dragondgold/DigitalPowerSupply/UI_Firmware/U8g2_Arduino-master/README.md

# U8g2_Arduino: Arduino Monochrome Graphics Library

https://raw.githubusercontent.com/wiki/olikraus/u8g2/img/uc1701_dogs102_uno_board_320.jpg 

U8glib V2 library for Arduino

Description: https://github.com/olikraus/u8g2/wiki

Issue Tracker: https://github.com/olikraus/u8g2/issues

Download: https://github.com/olikraus/U8g2_Arduino/archive/master.zip
