dragondgold/DigitalPowerSupply/Documentacion/Informe.pdf

# Diseño y construcción de fuente conmutada tipo Buck de 75W

### Análisis en detalle del diseño y desarrollo de una fuente conmutada para presentarse como trabajo final en la Universidad Tecnológica Nacional de la ciudad de San Francisco, Córdoba

### Torti Andrés - Anchino Leonardo

### 24 de Agosto de 2017

´

# Indice general

1. Introducción | 4
2. Convertidores Buck | 6
3. Controlador PID | 12
4. Circuito de control | 26
5. Software | 34
6. Mediciones | 36

1

UTN San Francisco | Anchino Leonardo – Torti Andrés
7. Conclusión | 39
8. Bibliografía y Contacto | 40

2

´

# Indice de figuras

1.1. Diagrama en bloques del sistema | | 5
1.2. Sistema de lazo cerrado | | 5
2.1. Esquema simplificado de un convertidor tipo Buck | | 6
2.2. Diagrama de corrientes del convertidor Buck | | 7
2.3. Esquema del Convertidor Buck Sincrónico | | 8
3.1. Diagrama de un convertidor tipo Buck | | 12
3.2. Estados ON y OFF del convertidor Buck | | 13
3.3. Formas de onda del convertidor Buck | | 14
3.4. Circuito equivalente promediado durante un período Ts | | 15
3.5. Circuito equivalente en DC | | 16
3.6. Circuito equivalente lineal y completo | | 17
3.7. Convertidor buck linealizado | | 17
3.8. Respuesta transitoria de lazo cerrado | | 20
3.9. Configuración del bloque PID | | 21
3.10. Respuesta transitoria - Sistema Discreto | | 23
3.11. Respuesta en frecuencia - Diagrama de Bode - Sistema Discreto | | 24
3.12. Diagrama de polos y ceros - Sistema Discreto | | 25
4.1. Esquema principal del circuito de control | | 27
4.2. Circuito de acondicionamiento de señal | | 28
4.3. Ilustración del concepto de Dead-Time o tiempo muerto | | 29
4.4. Leading-Edge Blanking | | 30
4.5. Circuito de realimentación de tensión | | 30
4.6. Circuito de realimentación de corriente | | 32
6.1. Tiempo de subida de 1V a 20V de 308µs | | 38
6.2. Tiempo de bajada de 20V a 1V de 476µs | | 38

3

# Capítulo 1

# Introducción

## 1.1. Objetivos

El objetivo de este proyecto fue construir una fuente conmutada de 75W que provea diversidad de tensiones de salida reguladas y controladas por medio de un sistema PID. Se hará uso de un convertidor tipo Buck para la salida principal y regulable de potencia, así como otros reguladores existentes en el mercado para proveer tensiones fijas y auxiliares. Todo el sistema será controlado por medio de un DSP que implementará el sistema de control PID. El proyecto tiene un fin meramente de investigación y representa un reto ya que el tema fuentes conmutadas no se desarrolla durante la carrera.
Se plantearon las siguientes especificaciones para la fuente:
Parámetro | Descripción | Min | Tip | Max | Unidad
Vin | Tensión de entrada | 200 | 220 | 240 | VAC
Vbuck(1) | Tensión Buck | 0 | - | 25 | V
Ibuck(1) | Corriente salida Buck | 0 | - | 3 | A
Vripple(1) | Tensión ripple Buck | - | - | 10 | mV
Vout(3) | Tensión salida auxiliar 1 | 3.2 | 3.3 | 3.4 | V
Iout(3) | Corriente salida auxiliar 1 | 0 | - | 300 | mA
Vout(4) | Tensión salida auxiliar 2 | 4.9 | 5 | 5.1 | V
Iout(4) | Corriente salida auxiliar 2 | 0 | - | 1 | A
η | Eficiencia estimada | | 80 | | %

Tabla 1.1: Parámetros de la fuente

Es importante aclarar que los 75W de salida son compartidos entre todas las salidas, tanto la variable como las auxiliares
El siguiente diagrama en bloques representa la estructura general de la fuente, cada bloque será analizado en detalle en los capítulos posteriores:

4


Figura 1.1: Diagrama en bloques del sistema

## 1.2. Sistema de control PID

Para poder lograr una tensión estable y regulada en la salida se debe implementar un lazo de realimentación, en nuestro caso, un sistema PID fue elegido debido a que el mismo nos permitirá no solo controlar de forma precisa la tensión de salida sino que también evitará transitorios que puedan ocurrir por ejemplo durante la conexión y desconexión de dispositivos a la fuente o cambios bruscos de corriente.

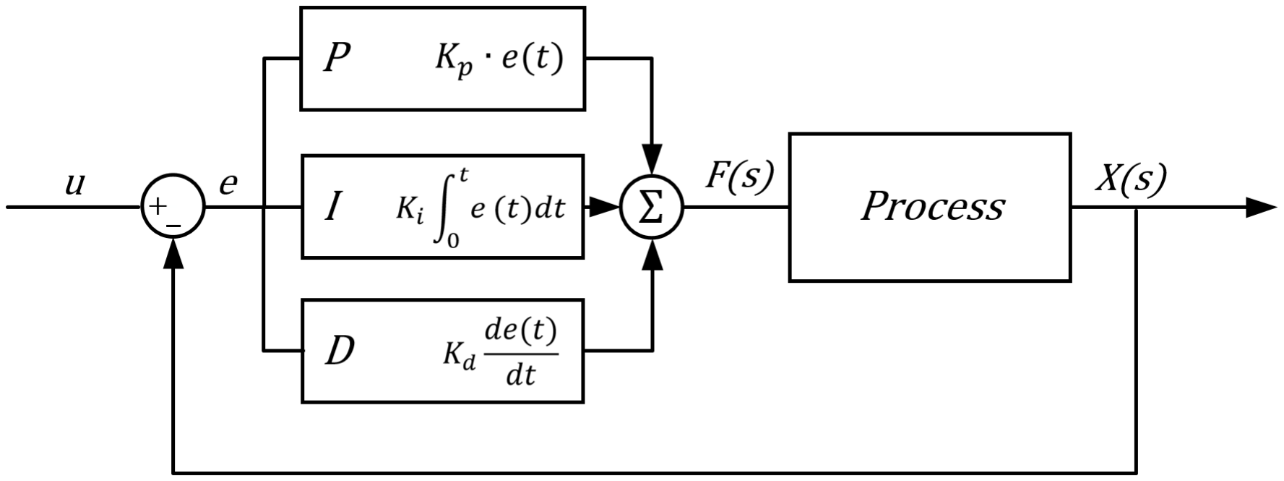
[picture p27: figure]

Figura 1.2: Sistema de lazo cerrado

En el capítulo Controlador PID desarrollaremos y explicaremos la función de transferencia del sistema de forma detallada y calcularemos los coeficientes del controlador PID con ayuda del software MATLAB® para así simular su comportamiento y compararlo con el circuito real implementado.

5

# Capítulo 2

# Convertidores Buck

## 2.1. Principio de funcionamiento

La fuente posee una salida regulable e independiente de potencia implementada con un convertidor Buck. El mismo tiene su entrada conectada a los +30V DC que provienen de la salida rectificada y filtrada del transformador y es el encargado de reducir la tensión que se le suministra para proveer un rango que varia entre 0V y 30V aproximadamente. A continuación se presenta un diagrama simplificado de la topología Buck:

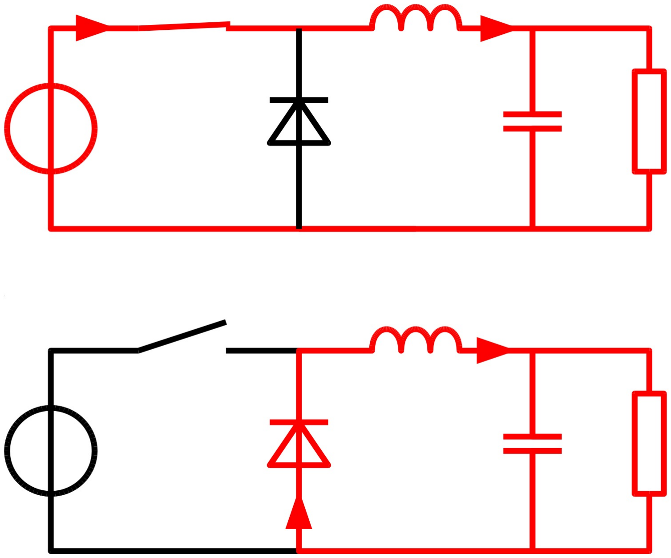
[picture p28: figure]

Figura 2.1: Esquema simplificado de un convertidor tipo Buck

6

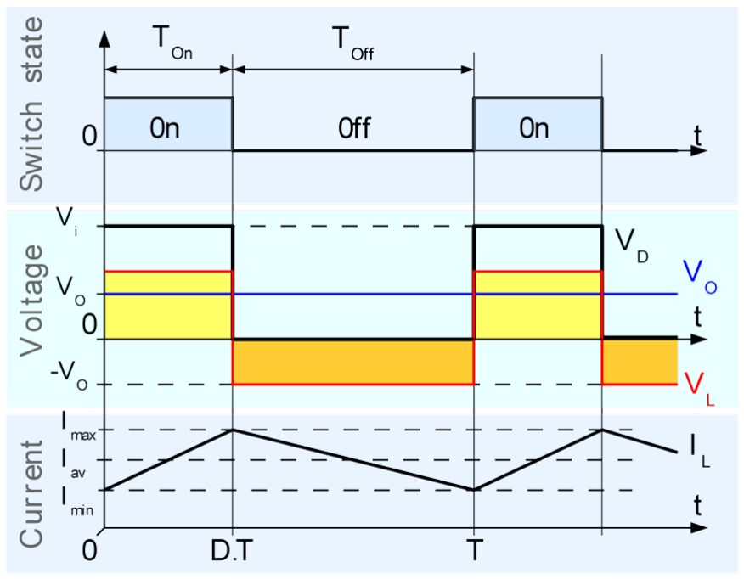
[picture p29: figure]

Figura 2.2: Diagrama de corrientes del convertidor Buck

Como podemos observar existen dos estados durante la operación del Buck. El primero de ellos es cuando el interruptor se encuentra cerrado durante un tiempo Ton como se observa en la figura 2.2, en este instante una tensión constante ≈ Vin es aplicada sobre el inductor por lo que la corriente comienza a aumentar de forma lineal y por consiguiente producirá una tensión inversa en respuesta al incremento de la corriente que es a su vez opuesta a la fuente, por lo tanto la tensión vista por la carga es menor a Vin.
En el segundo estado cuando abrimos el interruptor durante el tiempo Tof f , la energía almacenada en el inductor es la que produce la circulación de corriente que alimenta al circuito a través del diodo en paralelo.
En la práctica, el interruptor es reemplazado en general por un MOSFET de baja Rds(on) y el tipo de diodo es en general de tipo Schottky debido a su alta velocidad de conmutación, baja caída de tensión y baja capacidad parásita. En nuestro caso se optó por un circuito ligeramente distinto en donde el diodo es reemplazado por otro transistor MOSFET. El principio de funcionamiento es muy similar pero se reducen las pérdidas producidas por el diodo. A este tipo de Buck se lo conoce como Convertidor Buck Sincrónico o Synchronous Buck Converter. El esquema del convertidor Buck final se muestra a continuación:

7

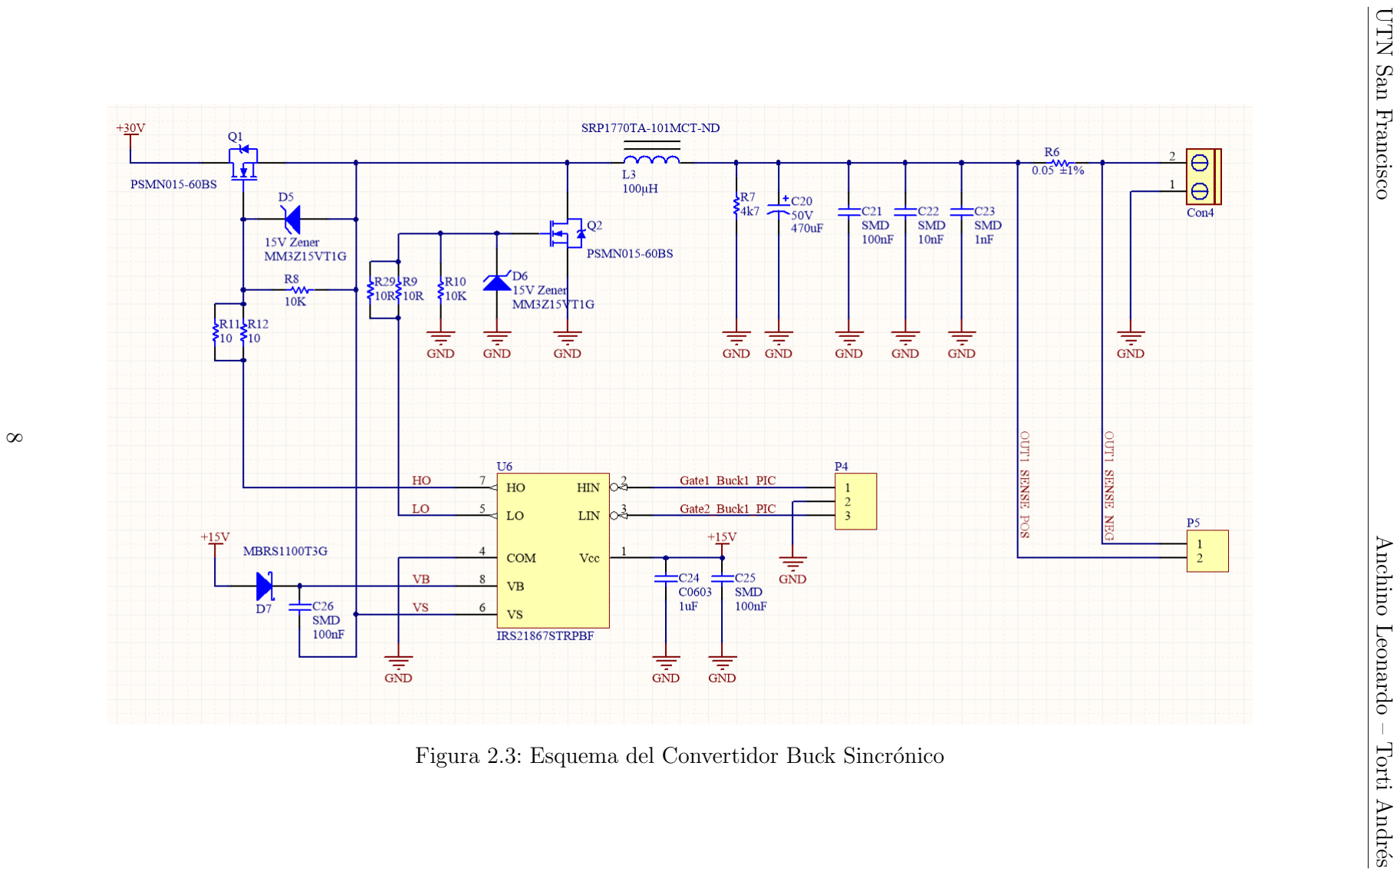
[picture p30: page 9]

UTN San Francisco Anchino Leonardo – Torti Andrés Figura 2.3: Esquema del Convertidor Buck Sincrónico

8

Para los cálculos de la mayor parte de los componentes del convertidor se utilizó la nota de aplicación ”Basic Calculation of a Buck Converter’s Power Stage”de (http://www.ti.com/lit/an/slva477b/slva477b.pdf) Texas Instruments.
Antes de realizar el cálculo de los componentes del convertidor presentamos los parámetros elegidos para su diseño:
Parámetro | Descripción | Min | Tip | Max | Unidad
Vout | Tensión de salida | 0 | - | 25 | V
Iout | Corriente de salida | 0 | - | 3 | A
Vripple | Tensión de ripple pico a
| pico | - | - | 10 | mV

Iripple

Corriente de ripple del
| inductor | 300 | mA
Fsw | Frecuencia de conmutación | 300 | KHz

Tabla 2.1: Parámetros de la fuente

## 2.2. Cálculo del inductor

El valor del inductor viene dado por la ecuación:

| Lmin[µH] = Vout · (Vin − Vout)
| ∆I · fsw · Vin | · 10 × 10⁶
| = 15 · (30 − 15)
| 300 × 10⁻³ · 300 × 10³ | · 30
- 10 × 10⁶
| = 83µH

(2.1)

Significa que necesitaremos un inductor de al menos 83µH, se utilizará uno de 100µH. Se puede ver que se eligió una tensión de salida de 15V para el cálculo cuando las especificaciones dicen que la misma varía entre 0 y 25V; esto es debido a que cuando la tensión de salida es variable se debe considerar el peor caso que es cuando Vout = Vin/2, en ese punto es donde se requiere el mayor valor de inductancia para mantener la corriente de ripple dentro de los límites establecidos.
La elección de la corriente de ripple es una solución de compromiso, aumentar la misma nos permite utilizar valores de inductancia más pequeños pero degradando la regulación y produciendo un mayor estrés sobre el capacitor de salida que debe ser seleccionado para soportar la misma, así como un mayor ripple provocado por el ESR del capacitor, además, la corriente de salida mínima para no entrar en operación de modo discontinuo está directamente relacionada con la corriente de ripple siendo la relación Iout(min) = Iripple/2, aunque cabe destacar que dicho efecto no se produce en los convertidores Buck Sincrónicos como en nuestro caso ya que al reemplazar el diodo por un MOSFET la corriente puede circular en ambos sentidos evitando que el convertidor entre en dicho modo. Este tema no se explicará en detalle aquí ya que no es el foco del análisis, para más información puede consultarse la siguiente nota de aplicación: ”Efficiency of synchronous versus nonsynchronous buck converters” (http://www.ti.com/lit/an/slyt358/slyt358.pdf)

9

## 2.3. Selección de los MOSFET de conmutación

Los transistores MOSFET son de gran importancia para lograr un buen rendimiento del convertidor. El MOSFET elegido fue un PSMN015-60BS (https://assets.nexperia.com/documents/data-sheet/PSMN015-60BS.pdf) que ocupará el lugar de Q1 y Q2 siendo manejados por el driver IRS21867S de Infineon. El transistor Q1 al ser del tipo N requiere una tensión de por lo menos 12V superior a la de entrada, es por ello que el driver elegido implementa una etapa de boostrap para elevar la tensión y poder saturar al MOSFET Q1.
Se calcula a continuación la disipación de potencia sobre estos MOSFET ya que su encapsulado es SMD y no es posible montarlos en disipadores, las pérdidas por conducción vienen dadas por:

PCON = I

2
D · Rds(typ)
- Dutymax = 3,15A

2

- 12.6 × 10⁻³Ω · 0,95 = 0,12W | (2.2)

Siendo la corriente máxima que circula por el MOSFET Iout + Iripple/2 = 3A + 0,15A y asumiendo un Duty Cycle máximo del 95 %.
Las pérdidas por conmutación son un factor importante en las fuentes conmutadas y pueden ser iguales o superiores a las pérdidas por conducción, entonces:

PSW = Vmax ·

ID
2
- (tr + tf ) · fsw + (0,5 · Coss · V

2
max · fsw)

= 30V ·

3,15A
2
- (13 × 10⁻⁹

s + 7 × 10⁻⁹
s) · 300 × 10³Hz

+ (0,5 · 169 × 10⁻¹²F · 30V
2
- 300 × 10³Hz)

= 0,28W + 0,023W = 0,30W

(2.3)

Las pérdidas totales son entonces de Ptotal = PCON + PSW = 0,42W. Siendo la resistencia juntura-ambiente de 60°C/W con una disipación de 0.42W la temperatura de juntura se elevaría a 0,42W · 60°C/W = 25,2°C por encima de la temperatura ambiente y siendo TJ(max) = 175°C estamos dentro de los parámetros admisibles.

## 2.4. Capacitor de salida

La capacidad de salida viene dada por:

Cout(min) =

∆IL

8 · fsw · ∆Vout

=

0,15A
8 · 300 × 10³Hz · 10 × 10⁻³V = 60,25µF

(2.4)

Sin embargo, a estas frecuencia el valor del ESR del capacitor entra en juego por lo que existe una fuente de ripple más que debemos considerar, es por ello que es recomendado el uso de capacitores para alta frecuencia con un bajo ESR. Se utilizó un capacitor de 470µF con un ESR de 350mΩ:

10

ESRripple = ESR · ∆IL = 350 × 10⁻³Ω · 0,3A = 105mV | (2.5)

Vemos como solo el ESR del capacitor produce un ripple varias veces superior al ripple causado por la rectificación. La única forma de reducir el mismo es utilizando inductores más grandes para atenuar la corriente de ripple o el uso de un capacitor con ESR aún más bajo.

## 2.5. Medición de corriente de salida

Para la medición de la corriente de salida se utiliza una resistencia de sensado en serie. Se utilizó una resistencia de 0,05Ω al 1 % con una estabilidad térmica de ±50ppm/°C. Esta señal diferencial es luego llevada al circuito de control donde se encuentra el acondicionamiento necesario para ser luego procesado por el DSP.

11

# Capítulo 3

# Controlador PID

## 3.1. Introducción

El convertidor Buck tiene aplicado un lazo de control PID para el control de la tensión y corriente de salida. Para poder simular y obtener los parámetros del controlador PID debemos desarrollar en primer lugar la función de transferencia de nuestro sistema, para ello vamos a suponer que:

Consideraremos el análisis de un Buck convencional y no uno sincrónico, la única diferencia radica en la caída de tensión producida por el semiconductor que se coloque en la posición del diodo

El convertidor Buck siempre opera en modo continuo

Se desprecian las inductancias y capacidades parásitas

Podemos entonces diagramar un circuito equivalente a nuestro convertidor Buck como el siguiente:

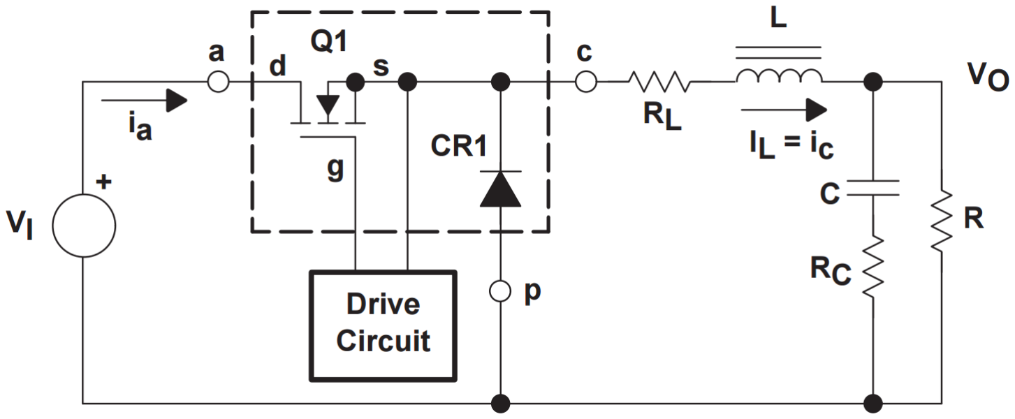
[picture p31: figure]

Figura 3.1: Diagrama de un convertidor tipo Buck

12

Podemos simplificar aún más el diagrama analizándolo en los dos estados del convertidor, cuando Q1 conduce y mientras no lo hace, los que llamaremos estados ON y OFF:


Figura 3.2: Estados ON y OFF del convertidor Buck

## 3.2. Circuito equivalente de conmutación promedia-

do

Para comenzar a modelar el convertidor Buck primero debemos linealizar los componentes cuyo comportamiento no es lineal, es decir, aquellos que en este caso son elementos de conmutación como el MOSFET y el diodo aquí llamado CR1 para no confundirlo con el duty cycle que será representado con la letra D. Vamos a reemplazar entonces lo que se encuentra dentro del cuadro con lineas intermitentes en la figura 3.1, que es el circuito de conmutación, por un sistema equivalente linealizado. Si observamos la siguiente figura

13 mostrando las formas de onda de corriente y tensión del convertidor:


Figura 3.3: Formas de onda del convertidor Buck

Podemos entonces formular las siguientes dos ecuaciones considerando que d representa el duty cycle que varía entre 0 y 1:

ia(t) =

ic(t) | durante d · Ts
0 | durante d⁰ · Ts

(3.1)

vcp(t) =

vap(t) | durante d · Ts
0 | durante d⁰
- Ts

(3.2)

Donde ia(t) e ic(t) son las corrientes instantáneas durante un período Ts y vcp(t) y vap(t) son las tensiones instantáneas entre los puntos CP y AP respectivamente. Si tomamos entonces el promedio de cada una de estas ecuaciones podemos escribir que:

Ia = d · Ic | (3.3)

14

Vcp = d · Vap | (3.4)

Tomando como notación que las letras mayúsculas indican valores promedios o DC y las minúsculas aquellas que varían como el Duty Cycle d. Con estas expresiones podemos entonces reemplazar el bloque en línea de puntos que se mencionó antes de la siguiente forma:

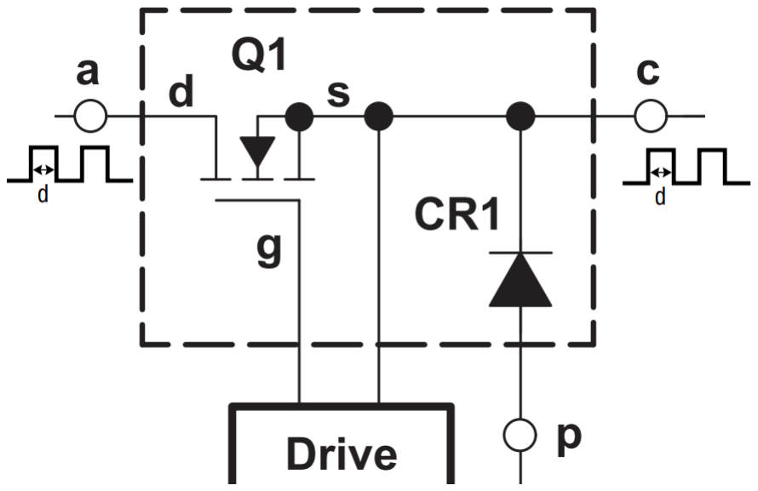
[picture p32: figure]

(a) Circuito original | (b) Circuito equivalente promedidado (no lineal)

Figura 3.4: Circuito equivalente promediado durante un período Ts

Donde se reemplaza el MOSFET y el diodo por una fuente de corriente y de tensión respectivamente.

## 3.3. Circuito equivalente de conmutación linealizado

El siguiente paso es realizar un proceso perturbación y linealización. La idea detrás del mismo es asumir un punto de operación e introducir pequeñas variaciones alrededor de ese punto para linealizar el sistema, es decir, decimos que el Duty se encuentra en un valor fijo D en estado estable y se le agrega al mismo una variación ˆd(t), entonces:

d(t) = D + ˆd(t) | (3.5)

Aplicamos así este proceso a las ecuaciones 3.3 y 3.4:

Ia +îa(t) = (D + ˆd(t)) · (Ic +îc(t))

= D · Ic + D · îc(t) + ˆd(t) · Ic + ˆd(t) · îc(t)

(3.6)

Vcp + ˆvcp(t) = (D + ˆd(t)) · (Vap + ˆvap(t))

= D · Vap + D · vâp(t) + ˆd(t) · Vap + ˆd(t) · vâp(t)

(3.7)

Como las variaciones son pequeñas, el producto de dos variaciones pequeñas es aún más pequeño por lo que podemos eliminarlas:

Ia +îa(t) = D · Ic + D · îc(t) + ˆd(t) · Ic
(3.8)
Vcp + ˆvcp(t) = D · Vap + D · vâp(t) + ˆd(t) · Vap | (3.9)
15

Separamos entonces los términos constantes de los que presentan variación:

1. Términos constantes en el tiempo

Ia = D · Ic

Vcp = D · Vap

2. Términos variables en el tiempo îa(t) = D · îc(t) + ˆd(t) · Ic

vĉp(t) = D · vâp(t) + ˆd(t) · Vap

Si analizamos los términos constantes podemos realizar el siguiente circuito equivalente considerando un transformador ideal (independiente de la frecuencia) con una relación de transformación D:


Figura 3.5: Circuito equivalente en DC

Podemos ver que el circuito cumple con las dos ecuaciones constantes en el tiempo. Incorporamos ahora los términos variables y reflejando las fuentes al lado primario del transformador ideal tenemos:

16

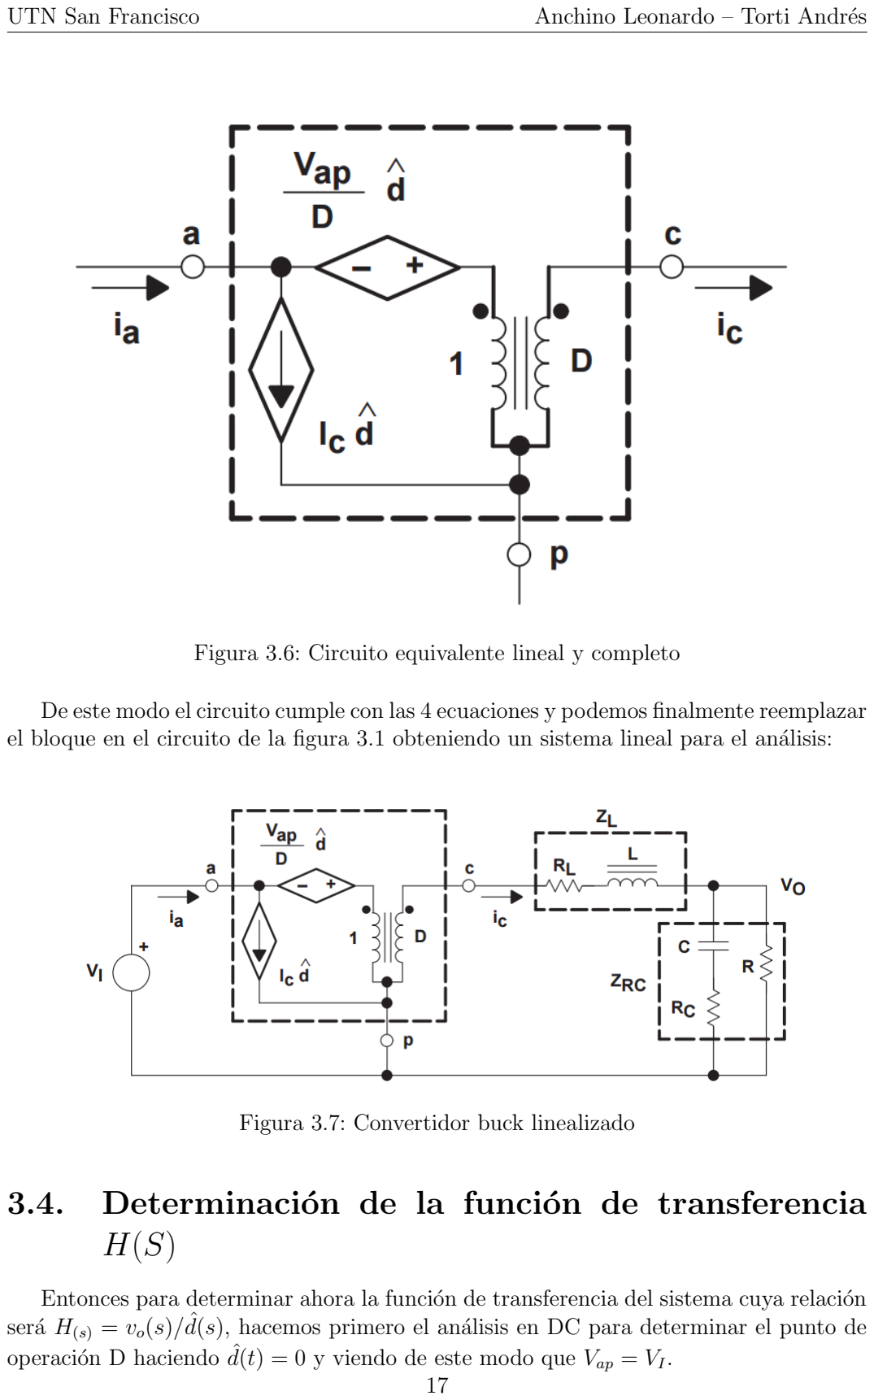
[picture p33: page 18]

Figura 3.6: Circuito equivalente lineal y completo

De este modo el circuito cumple con las 4 ecuaciones y podemos finalmente reemplazar el bloque en el circuito de la figura 3.1 obteniendo un sistema lineal para el análisis:

Figura 3.7: Convertidor buck linealizado

## 3.4. Determinación de la función de transferencia

H(S)

Entonces para determinar ahora la función de transferencia del sistema cuya relación será H(s) = vo(s)/

ˆd(s), hacemos primero el análisis en DC para determinar el punto de operación D haciendo ˆd(t) = 0 y viendo de este modo que Vap = VI .
17

Luego hacemos VI = 0 para tener únicamente la componente AC de la función de transferencia y escribimos la ecuación de malla del primario:

−

Vap
D

·

ˆd(t) + vĉp(t)
D

= 0 ∴ vĉp(t) = Vap ·

ˆd(t) ∴ | vĉp(t) = VI ·
ˆd(t) | (3.10)

O de otra forma:

vĉp(s)
ˆd(s)
| = VI | (3.11)

Y sabiendo que la función de transferencia entre la tensión de salida y vcp es (tratándolo como un divisor de tensión de impedancias):

vô(s) vĉp(s) = | ZRC(s)
ZRC(s) + ZL(s)
| | (3.12)

En donde ZL(t) es:

ZL(t) = RL + jω · L ∴ | ZL(s) = RL + s · L | (3.13)

Y donde ZRC es:

ZRC =

1
jωC + RC
k R

=

1
jωC + RC
- R

1
jωC + RC + R

=

R
sC + RC · R

1
sC + RC + R

=

R + s · C · RC · R

✘s ·✘C✘
1 + s · C · RC + s · C · R

✘s ·✘C✘

=

R + s · C · RC · R
1 + s · C · RC + s · C · R

=

R · (1 + s · C · RC)
1 + s · C · (RC + R)

(3.14)

Por lo tanto:

18

vô(s)
vĉp(s)

=

R · (1 + s · C · RC)
1 + s · C · (RC + R)
R · (1 + s · C · RC)
1 + s · C · (RC + R)

+ RL + s · L

=

A
B
A
B

+ RL + s · L

=

A
B
A + RL · B + s · L · B
B

=

A
A + RL · B + s · L · (1 + s · F · (RC + R))
| | {z | }
| B

(3.15)

=

A
A + RL · B + s · L + s

2
- L · C · (R + RC)

=

R + s · R · RC · C
(R + s · R · RC · C) + (RL + RL · s · C · (R + RC))+ s · L + s

2
- L · C · (R + RC)

=

R + s · R · RC · C
s

2
- [L · C · (R + RC)] + s · [R · RC · C + RL · C · (R + RC) + L] + (R + RL)

Finalmente podemos reemplazar y escribir la función de transferencia ˆvo(s)/

ˆd(s):

H(S) = vô(s)
ˆd(s)

=

vĉp(s)
ˆd(s)

·

vô(s)
vĉp(s)

= VI ·

R + s · R · RC · C
s

2
- [L · C · (R + RC)] + s · [R · RC · C + RL · C · (R + RC) + L] + (R + RL) (3.16)

## 3.5. Cálculo de los parámetros PID en MATLAB®

Insertamos ahora nuestra función de transferencia H(s) en MATLAB® utilizando el siguiente programa:

19

1 s = t f ( ’ s ’ ) ;
2
3 | R = 1 0; | % R e s i s t e n c i a de ca rga [Ohm]
4 | Rc = 0 . 3 5 ; | % ESR d el c a p a c i t o r de s a l i d a [Ohm]
5 | C = 470 e −6; | % Capacidad de s a l i d a
6 | Rl = 118 e −3; | % R e s i s t e n c i a d el i n d u c t o r
7 | L = 100 e −6; | % I n d u c ta n cia
8 | Vi = 3 0; | % Tensin de en t rada a l buck
9
10 | % Funcin de t r a n s f e r e n c i a d el Co n v e r ti do r Buck
11 | H = Vi * ( (R + ( s *R*Rc*C) ) / ( ( s ˆ2 ) * (L*C*(R+Rc ) ) + s *(R*Rc*C +
Rl*C*(R+Rc ) + L) + R + Rl) )

Teniendo entonces la función de transferencia de la planta vamos a modelar el sistema completo en Simulink para obtener los valores de Kp, Ki, Kd y la respuesta del sistema en lazo cerrado. Se presenta en la siguiente imagen el sistema que se simuló con Simulink:

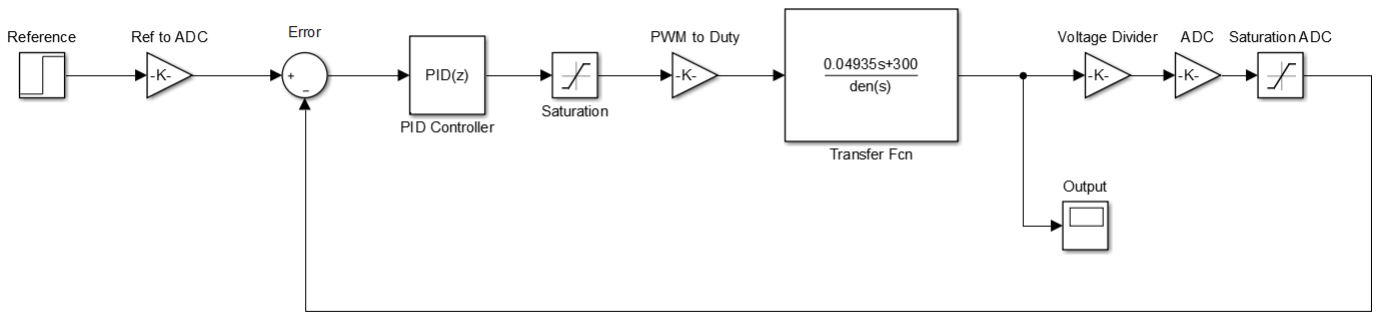
[picture p34: figure]

Figura 3.8: Respuesta transitoria de lazo cerrado

La ventaja de la modelización del sistema en Simulink es que pueden considerarse todas las variables como el efecto del tiempo de muestreo y los valores máximos y mínimos que pueden tomar las variables de entrada/salida.
Obtenemos entonces los valores de Kp, Ki y Kd utilizando el asistente de MATLAB® para realizar el tuning del PID y ajustando luego los valores manualmente para obtener los resultados deseados en la simulación. Ya habiendo entonces obtenido los valores de Kp, Ki y Kd podemos obtener la repuesta de nuestro sistema discreto:

20

## 3.6. Análisis de respuesta del sistema

La siguiente imagen muestra la configuración del bloque PID. Es importante configurar de manera correcta este bloque ya que de su función de transferencia se determinará el algoritmo a ser usado luego en el DSP para realizar el control.


Figura 3.9: Configuración del bloque PID

Los parámetros más importantes aquí son el tiempo de muestreo que en nuestro caso es de 6,66µs y la función de transferencia del bloque dada por:

Ts = P + I ×

Ts
2

×

z + 1
z − 1

+ D ×

1
Ts

×

z − 1
z

(3.17)

Que traducido a la implementación en un microcontrolador puede escribirse como:

u[k] = u[k − 1] + a × e[k] + b × e[k − 1] + c × e[k − 2] | (3.18)
21

En donde u es la salida del controlador, k es la muestra actual, e es el error y los coeficientes a, b y c están dados por:

a = Kp + Ki ×

Ts
2

+

Kd
Ts

(3.19)

b = −Kp + Ki ×

Ts
2

−

2Kd
Ts

(3.20)

c =

Kd
Ts

(3.21)

Que como se verá luego, puede ejecutarse muy rápidamente en un DSP con las instrucciones MAC que proporciona.
Con estas configuraciones se realiza el análisis del sistema con la herramienta Linear Analysis Tool de Simulink que se encuentra en Analysis Control Design Linear Analysis. Los valores para las constantes del PID obtenidas son Kp = 5, Ki = 40000 y Kd = 5 × 10⁻⁶

### 3.6.1. Respuesta transitoria

En la figura 3.10 se observa la respuesta al escalón unitario del sistema de lazo cerrado. Vemos una sobre-elongación del 6.78 %. Se estableció una solución de compromiso priorizando un error de estado estacionario nulo. Reducir la constante Ki reduce la sobre-elongación pero aumenta el error de estado estacionario rápidamente.

### 3.6.2. Respuesta en frecuencia

Observando la figura 3.11 vemos como el ancho de banda del sistema es de 55kHz. El margen de ganancia indica que podemos agregar hasta 15.4db de ganancia al lazo sin desestabilizar el sistema.

### 3.6.3. Diagrama de polos y ceros

En la figura 3.12 se observa que todos los polos y ceros se encuentran dentro del radio unitario y en un sistema discreto esto significa que el mismo es estable.

22

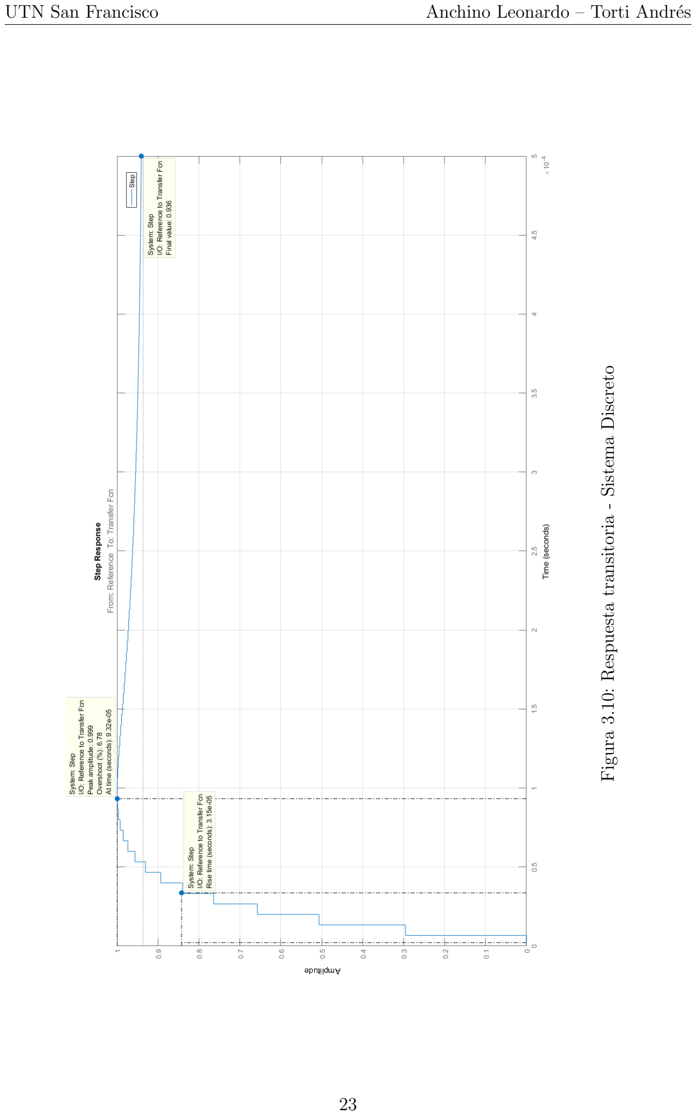
[picture p35: page 24]

UTN San Francisco | Anchino Leonardo – Torti Andrés Figura 3.10: Respuesta transitoria ⁻ Sistema Discreto

23

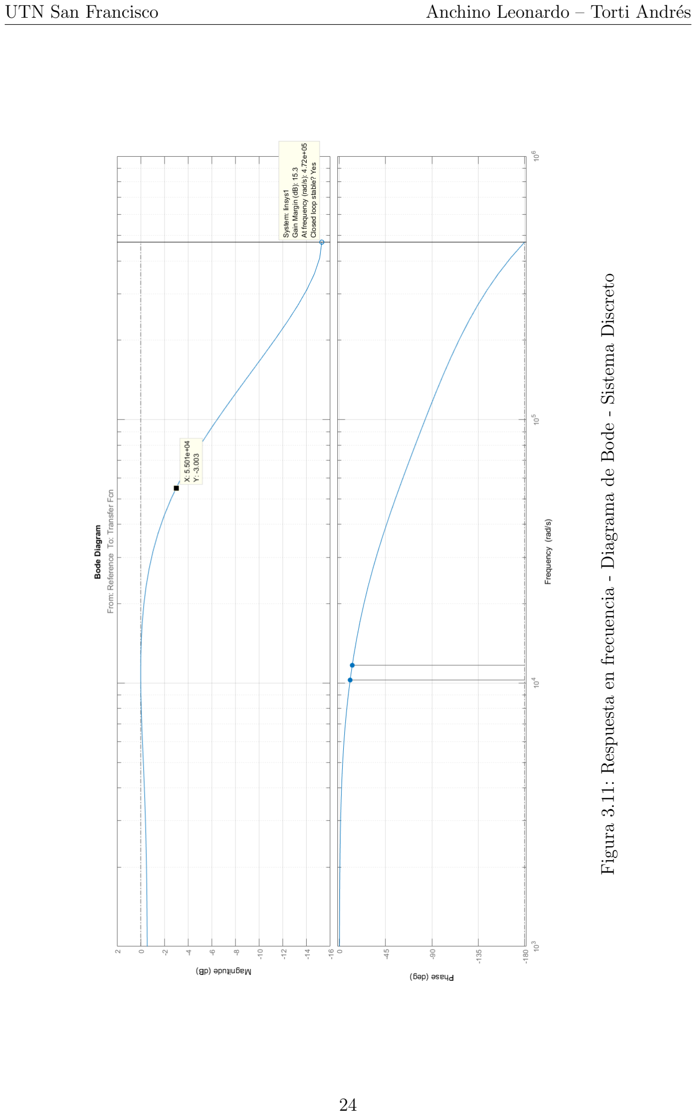
[picture p36: page 25]

UTN San Francisco | Anchino Leonardo – Torti Andrés Figura 3.11: Respuesta en frecuencia ⁻ Diagrama de Bode ⁻ Sistema Discreto

24

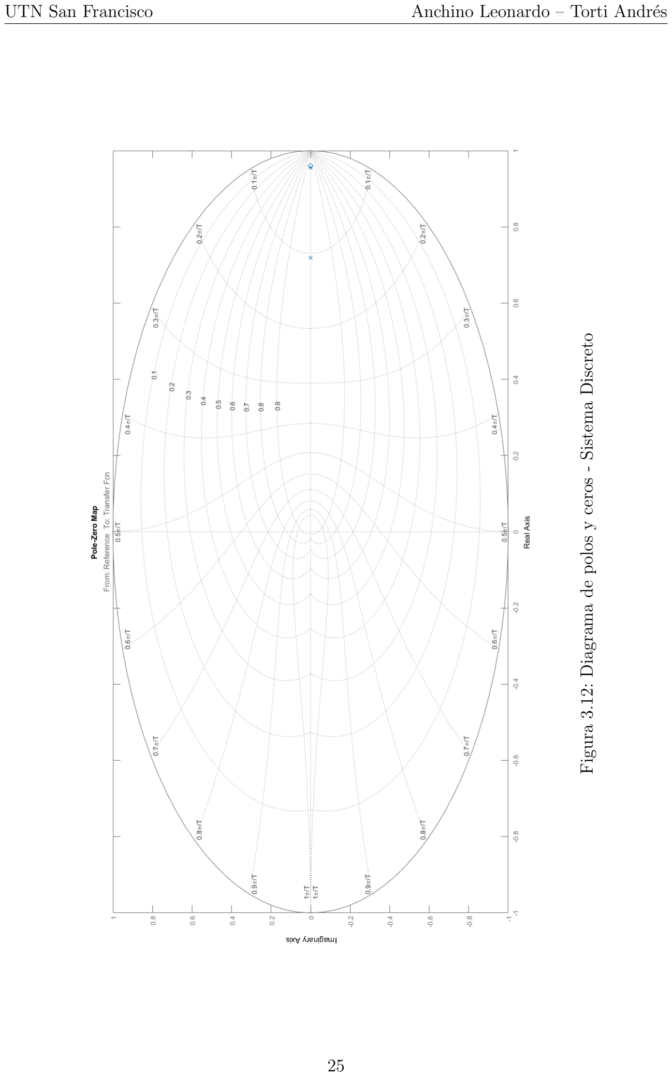
[picture p37: page 26]

UTN San Francisco | Anchino Leonardo – Torti Andrés Figura 3.12: Diagrama de polos y ceros ⁻ Sistema Discreto

25

# Capítulo 4

# Circuito de control

## 4.1. Introducción

El circuito de control es el encargado de controlar el convertidor Buck y aplicar el controlador PID, además de monitorear las tensiones y corrientes de cada una de las salidas. Las figuras 4.1 y 4.2 muestran los esquemáticos correspondientes al circuito de control y el de adaptación de señal. A continuación, vamos a analizar en detalle cada una de las partes que integran al circuito.

## 4.2. Microcontrolador DSP

El microcontrolador elegido es un dsPIC33EP64GS502 de la empresa Microchip® capaz de trabajar a una velocidad de hasta 70 MIPS con 64KB de memoria FLASH y 8KB de RAM. Las principales características por las que fue elegido son:

70 MIPS

Módulo PWM de alta velocidad que permite un control preciso del Duty Cycle respecto a los convencionales

Control de dead-time o tiempo muerto

ADC de alta velocidad de 12 bits capaz de capturar y convertir hasta 4 entradas analógicas de forma simultánea lo que permite muestrear los niveles de tensión y corriente en el mismo instante para tener un cálculo certero de la potencia

Núcleo DSP con instrucciones MAC (multiply-accumulate) de ciclo único lo que permite la ejecución de algoritmos como PID de forma rápida

Como se explica arriba, este microcontrolador tiene la posibilidad de generar tiempos muertos o Dead-Time en las señales PWM. Como recordamos, el Buck implementado es del tipo sincrónico por lo que mientras un MOSFET se enciende el otro permanece apagado. Debido a que el tiempo de transición entre encendido y apagado no es instantáneo se introduce un tiempo muerto entre las conmutaciones en donde ambos MOSFET se encuentran apagados. En la imagen 4.3 se ilustra el comportamiento descrito.

26

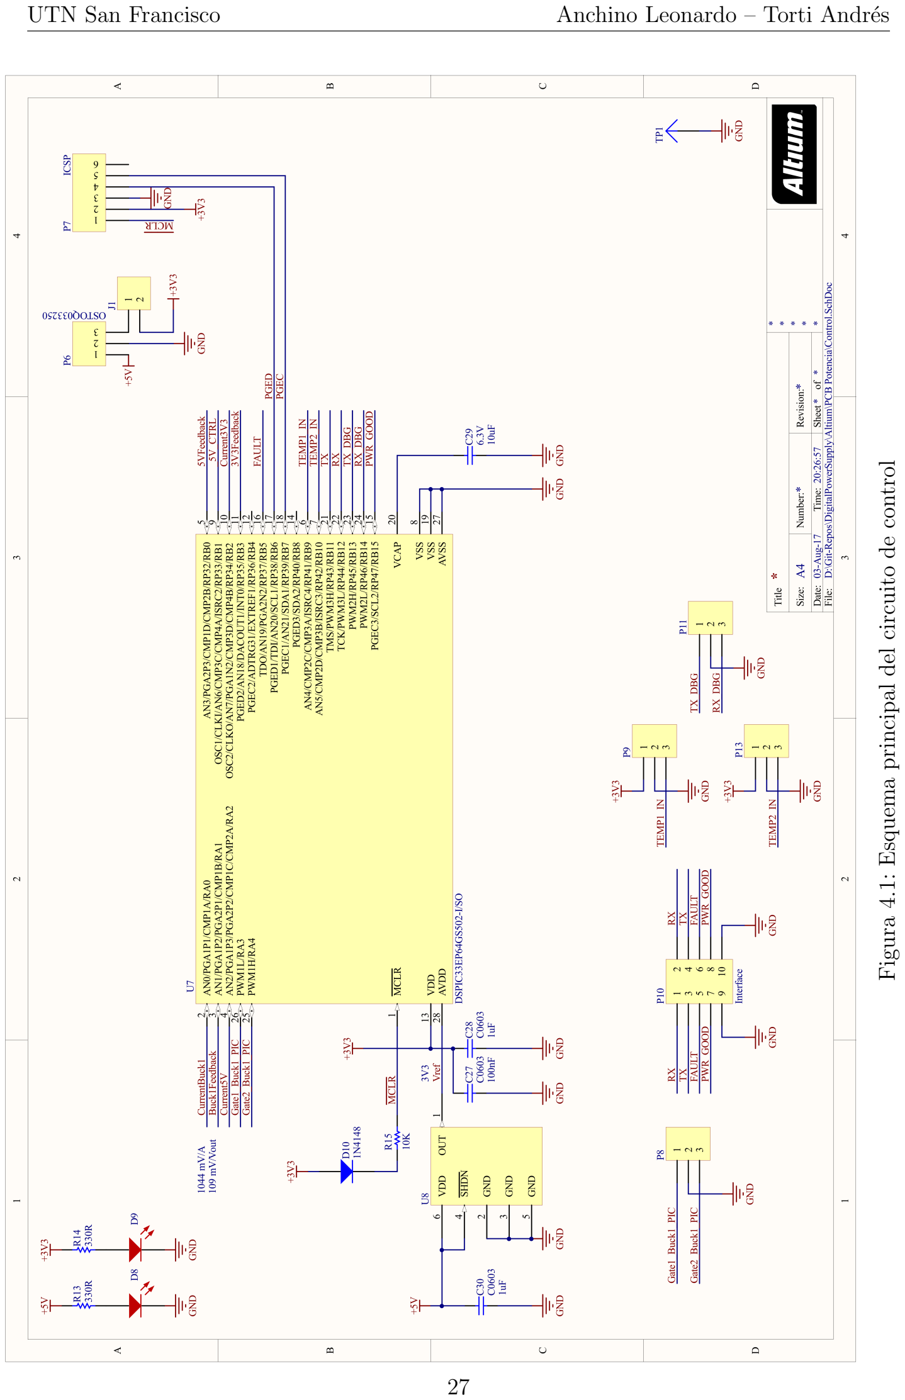
[picture p38: page 28]

UTN San Francisco | Anchino Leonardo – Torti Andrés Figura 4.1: Esquema principal del circuito de control

27

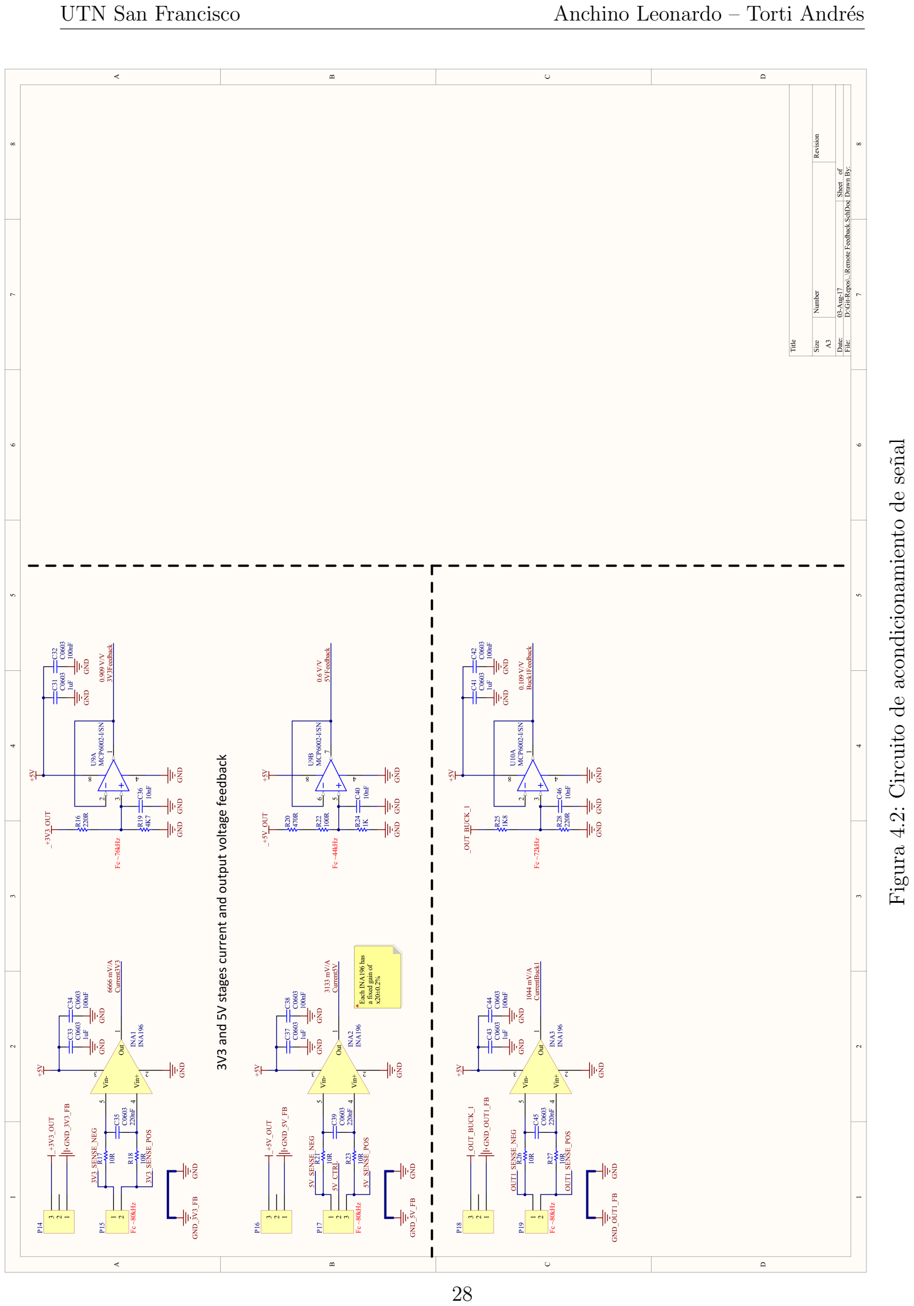
[picture p39: page 29]

Figura 4.2: Circuito de acondicionamiento de señal

28


Figura 4.3: Ilustración del concepto de Dead-Time o tiempo muerto

## 4.3. Metodología de muestreo

El DSP cuenta con 4 cores ADC que permiten convertir de forma simultánea hasta 4 entradas analógicas. De esta manera dr muestrea de forma simultánea la tensión y corriente de cada una de las salidas.
Todo este ciclo se repite cada 6,66µs que equivalen a 2 períodos del PWM.
La corriente no solo se mide a través de la lectura de los ADC sino que también es continuamente comparada con una tensión de referencia en los comparadores internos del DSP lo que permite reaccionar de manera instantánea a cualquier sobre-corriente sin necesidad de esperar al muestreo y conversión de las entradas analógicas.

## 4.4. Leading-Edge Blanking

Para la correcta lectura de la tensión de salida se utiliza una funcionalidad llamada Leading-Edge Blanking que provee el módulo PWM del DSP. Básicamente permite que la captura del ADC se realize un determinado tiempo después de los flancos de PWM para de este modo no capturar el ruido de conmutación y obtener una lectura correcta de la señal:

29

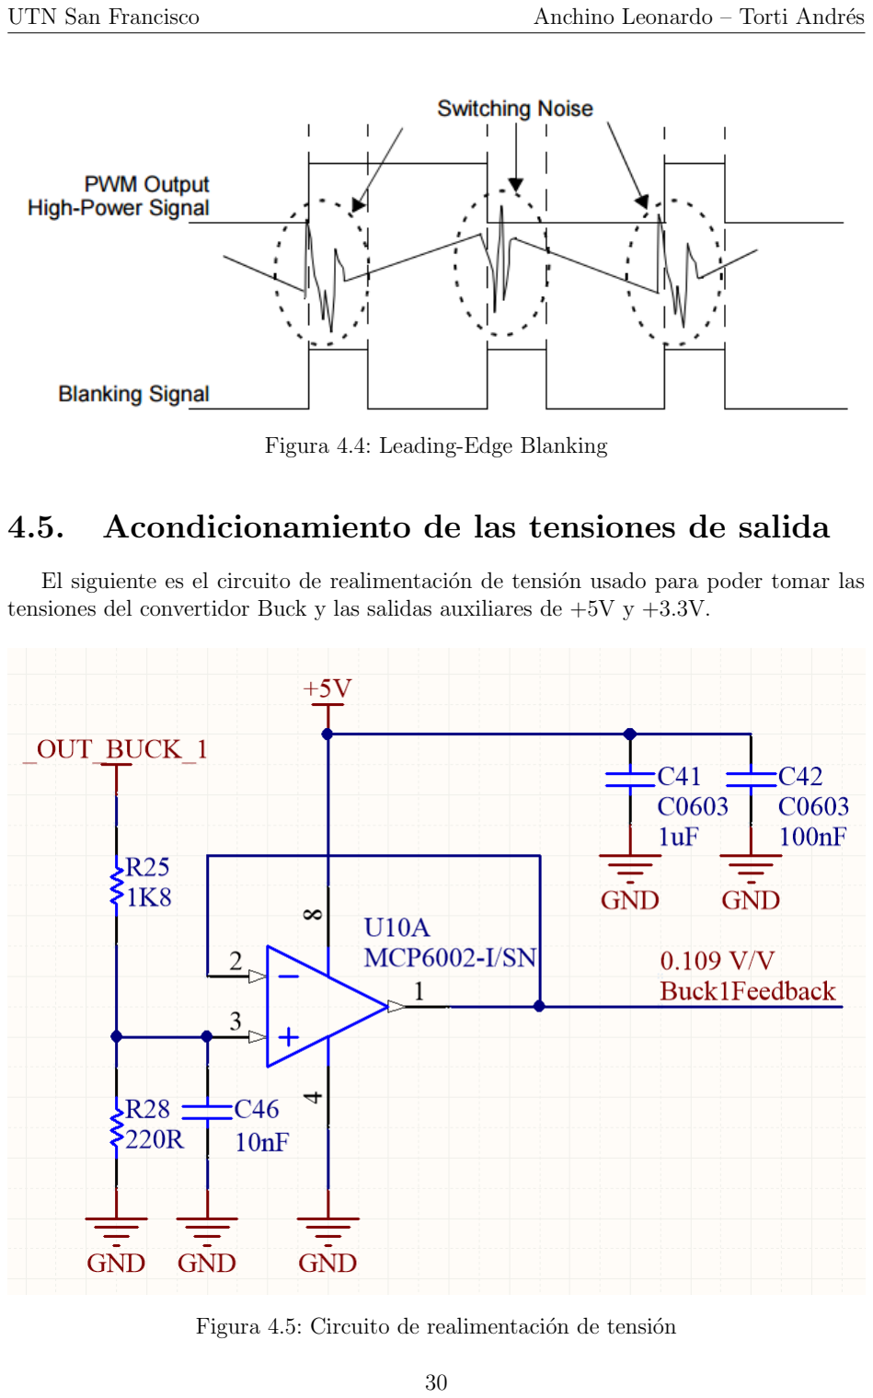
[picture p40: page 31]

Figura 4.4: Leading-Edge Blanking

## 4.5. Acondicionamiento de las tensiones de salida

El siguiente es el circuito de realimentación de tensión usado para poder tomar las tensiones del convertidor Buck y las salidas auxiliares de +5V y +3.3V.

Figura 4.5: Circuito de realimentación de tensión

30

El circuito es el mismo para todas las salidas variando únicamente el divisor resistivo de entrada al seguidor de tensión. Se debe tener en cuenta el offset introducido por el seguidor de tensión que se encuentra en el rango de ±4,5mV lo que por ejemplo, en la tensión de salida del Buck representaría un error de ±41mV de no ser compensado. La resolución del ADC del DSP es de 12 bits y teniendo una tensión de referencia para el ADC de 3.3V con una variación máxima de ±0,08 %, podemos calcular la resolución de tensión que tenemos al medir cada una de las salidas de la fuente y el error asociado. La resolución en tensión del ADC puede ser calculada como:

Resbuck = 3,3V/2

12 = 805,65µV | (4.1)

Resaux = 3,3V/2

12 = 805,65µV | (4.2)

Vamos a calcular el factor de atenuación de cada salida que viene dado por el valor de las resistencias en el divisor de tensión, tomando como ejemplo el circuito de la figura 4.5 el factor de atenuación esta dado como:

V o/V i =

220
220 + 1800
= 0,109 | (4.3)

Con la resolución del ADC y el factor de atenuación podemos calcular entonces la resolución que tenemos al medir la tensión de salida del Buck, en este caso:

Resolucion salida =

Res
V o/V i =

402.83 × 10⁻⁶µV
0,109
= 7,39mV | (4.4)

Como la tensión de referencia tiene una variación de ±0,08 %, la lectura del ADC se ve directamente afectada por esta referencia, por lo que la resolución de la tensión de salida también tendrá un error del ±0,08 % que se traduce en una variación de ±5,91µV . En la siguiente tabla se muestran los resultados del mismo procedimiento aplicado a las demás salidas:

Parámetro | Factor de atenuación Vo/Vi | Resolución | Error
Vbuck | 0.109 | 7.39mV | ±5,91µV
V5V | 0.637 | 1.25mV | ±1µV
V3,3V | 0.954 | 0.83mV | ±0,66µV

Tabla 4.1: Resolución de las tensiones de salida

31

## 4.6. Acondicionamiento de las corrientes de salida


Figura 4.6: Circuito de realimentación de corriente

Para medir la corriente de salida se toma la señal diferencial proveniente de las resistencias ubicadas en cada salida y se conectan a un amplificador para sensado de corriente INA196 pasando primero por un filtro pasa-bajos en la entrada. El amplificador tiene una ganancia fija de 20 por lo que las resistencias de sensado se calcularon en base a esta ganancia para obtener una tensión máxima de 3.3V a la salida. El circuito es el mismo para todas las salidas.
Utilizando la resolución del ADC obtenida en la sección anterior podemos calcular la resolución de corriente que tenemos en cada salida. Como se tiene una ganancia de 20, la resolución de tensión del ADC pasa a ser de:
Resbuck = 805,65µV/20 = 40,28µV | (4.5)
Resaux = 805,65µV/20 = 40,28µV | (4.6)

Tomemos como ejemplo la salida del buck cuya resistencia de sensado es de 50mΩ:

Resolucion Corriente = Res/50mΩ = 805,6µA | (4.7)

Aplicando el mismo proceso a todas las demás salidas:

32

Parámetro | Resistencia de sensado | Resolución
Ibuck | 50mΩ | 805,6µA
I5V | 100mΩ | 408,2µA
I3,3V | 150mΩ | 272,13µA

Tabla 4.2: Resolución de las corrientes de salida

Donde el error de la medición como en el caso anterior está dado por la variación máxima de la tensión de referencia del ADC, despreciando los efectos térmicos sobre las resistencias de sensado.

33

# Capítulo 5

# Software

## 5.1. PID

El programa del DSP fue escrito en C utilizando el compilador XC16 v1.31 de Microchip® excepto por el algoritmo del PID que fue diseñado e implementado en lenguaje ensamblador.
En el anexo se encuentra el programa que corresponde a la ejecución del algoritmo PID. Se aprovechan las instrucciones MAC (que permiten multiplicar y acumular en un solo ciclo de instrucción) y los dos acumuladores de 40 bits de los que dispone el DSP. Esta rutina se ejecuta cada 6,66µs por lo que es importante que se ejecute rápidamente, para ello el algoritmo solo utiliza números enteros de 16 bit por lo que deben convertirse todos los valores en coma flotante de las constantes del PID a enteros para ser utilizados. Como se describe en la ecuación 3.17 se calculan las constantes a, b y c para el controlador PID usando los valores Kp, Ki y Kd obtenidos:

a = Kp + Ki ×

Ts
2

+

Kd
Ts
= 6,3 | (5.1)

b = −Kp + Ki ×

Ts
2

−

2Kd
Ts
= −7,3 | (5.2)

c =

Kd
Ts
= 1,2 | (5.3)

Vemos que los valores obtenidos son pequeños y por lo tanto la parte decimal del número es un valor significativo. Como solo podemos utilizar valores enteros se afectará a la ecuación por un número potencia de 2. Recordemos la ecuación del PID usada en el DSP:

u[k] = u[k − 1] + a × e[k] + b × e[k − 1] + c × e[k − 2] | (5.4)

Si multiplicamos y dividimos este ecuación por un número x podemos escribirla como:

u[k] = u[k − 1] + a × x ×

e[k]
x

+ b × x ×

e[k − 1]
x

+ c × x ×

e[k − 2]
x
| (5.5)

Por lo que el valor de cada constante se convierte en un valor mayor que puede representarse más precisamente como un número entero, sin embargo, debemos tener en 34 cuenta que esto también limita el error mínimo que puede discriminar el controlador que será x ya que el error es también un número entero y cualquier valor en el intervalo (0,
1) será un 0.
Eligiendo x = 16, los valores de a, b y c quedan entonces como:

a = (Kp + Ki ×

Ts
2

+

Kd
Ts
) × 16 = 100,8 = 101 | (5.6)

b = (−Kp + Ki ×

Ts
2

−

2Kd
Ts
) × 16 = −116,8 = −117 | (5.7)

c = (Kd
Ts
) × 16 = 19,2 = 19 | (5.8)

35

# Capítulo 6

# Mediciones

A continuación se presentan las distintas mediciones realizadas a la fuente para verificar su estabilidad y tiempos de respuesta.

## 6.1. Regulación de linea

Para esta medición se utilizó un autotransformador para variar la tensión de entrada de la fuente y verificar la regulación de la tensión de salida. Se coloca la tensión de salida a su máximo valor (20V) y se coloca una carga de modo tal de consumir la corriente nominal de la fuente. En nuestro caso la máxima corriente que pudo ser usada en el ensayo fue de 2.22A en lugar de 3A.

Vacío | Carga
Vin | Iout | Vout | Iout | Vout
200V | 0A | 19.75V | 2.22A | 19.72V
220V | 0A | 19.75V | 2.22A | 19.72V
240V | 0A | 19.75V | 2.22A | 19.72V

Tabla 6.1: Regulación de línea

Con el multímetro utilizado (UNI-T IT61E) no pudo apreciarse ningún cambio significativo en la tensión de salida de la fuente debido al cambio de la tensión de entrada.

## 6.2. Regulación de carga

El objetivo de este ensayo es el de medir la variación de la tensión de salida frente a distintas condiciones de carga. Los resultados obtenidos fueron los siguientes:

36

Parámetro | Carga Nominal | Carga Media | Sin Carga
Vin | 220V | 220V | 220V
Vout | 19.71V | 19.73V | 19.75V
Iout | 2.21A | 0.94A | 0A

Tabla 6.2: Regulación de carga

La regulación de carga está entonces dada por:

Regulacion De Carga =

∆Vout

Voutnom

| | × 100 =
| | 0,04
| | 19,75
× 100 = 0,2 % | (6.1)

Lo cual indica que con una variación de carga de casi el 75 % (ya que las pruebas se hicieron en 2.21A en lugar de los 3A máximos de la fuente) tenemos una variación del 0.2 % en la tensión de salida.

## 6.3. Ripple

Se realizó la medición de ripple bajo dos condiciones de carga aplicando un filtro pasabajos para eliminar los ruidos de conmutación de los convertidores:

Parámetro | Carga Media | Carga Nominal
Vout | 20V | 20V
Vpp | 20mVpp | 20mVpp
Iout | 0.94A | 2.21A

Tabla 6.3: Regulación de carga

## 6.4. Tiempo de respuesta

Para la medición de los tiempos de respuesta de la fuente se aplicó una carga de 8Ω y se incrementó la tensión de salida de 1V a 20V para medir el tiempo de subida y viceversa para medir el tiempo de bajada. Los resultados obtenidos usando un osciloscopio Rigol DS1052E fueron:

37

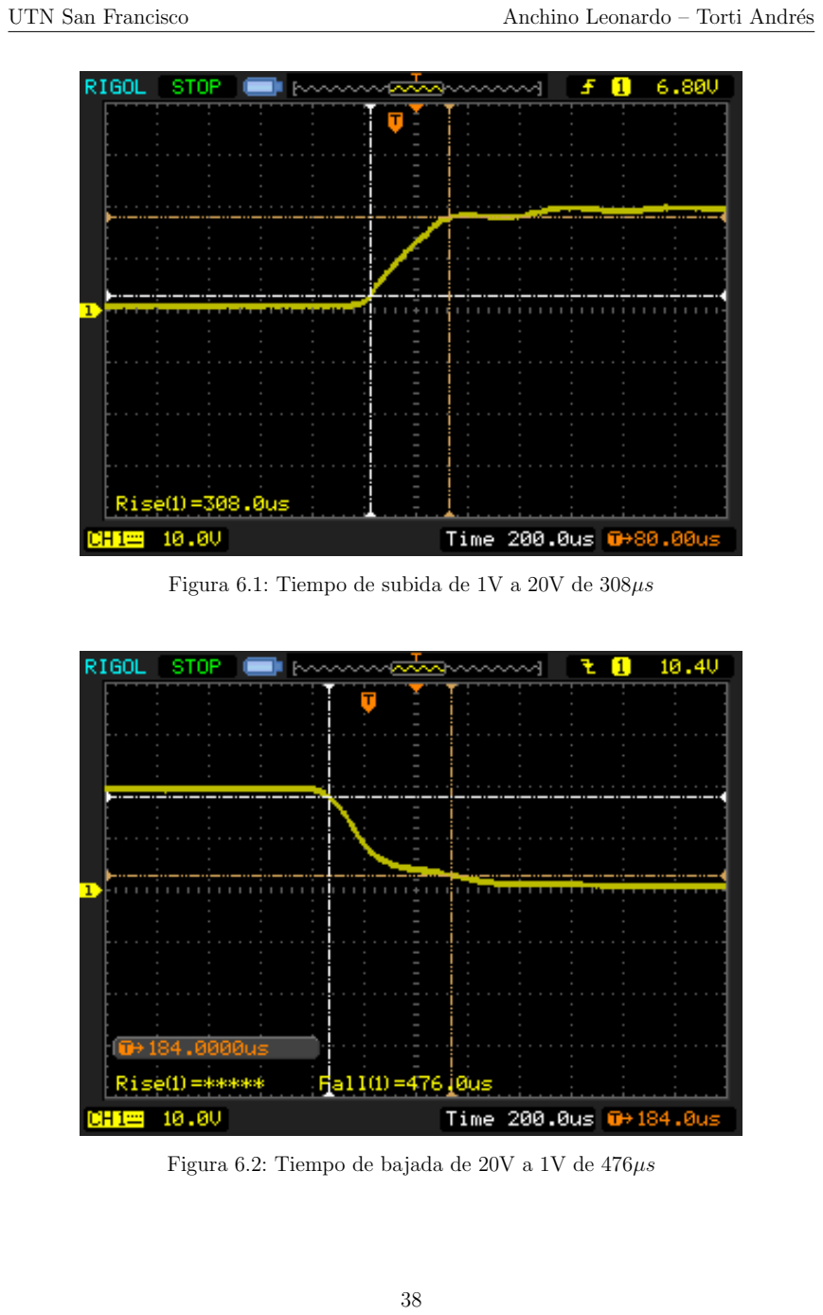
[picture p41: page 39]

Figura 6.1: Tiempo de subida de 1V a 20V de 308µs

Figura 6.2: Tiempo de bajada de 20V a 1V de 476µs

38

# Capítulo 7

# Conclusión

El sistema es estable y funciona perfectamente con los parámetros del PID calculados en MATLAB tal como lo indicaba el modelo en la teoría. El ripple es ligeramente superior al calculado debido al ESR de los capacitores. La regulación de carga y de línea es excelente manteniendo la tensión prácticamente sin variación.
En la simulación de MATLAB se observó un porcentaje considerable de sobre-tensión que no fue observado en el sistema real, esto puede deberse a los efectos parásitos del circuito que no fueron considerados y la pérdida de resolución debido a la utilización de enteros en lugar de coma flotante, aquí una posible mejora es la de utilizar punto fijo para aumentar la resolución. Otra mejora posible son el reemplazo del transformador de 50Hz por una fuente conmutada para poder sacar más potencia (la cual se encuentra limitada actualmente por el transformador) y reducir el peso.

39

# Capítulo 8

# Bibliografía y Contacto

dsPIC33FJ16GS402 Datasheet - http://ww1.microchip.com/downloads/en/DeviceDoc/70000318g.pdf (http://ww1.microchip.com/downloads/en/DeviceDoc/70000318g.pdf)

Marty Brown. (2001). Power Supply Cookbook 2nd Edition. USA: Newnes.

Keith H. Billings. (1989). Switchmode Power Supply Handbook. USA: McGraw-Hill.

Abraham I. Pressman. (2009). Switching Power Supply Design, Third Edition. USA: McGraw-Hill.

Microchip WebSeminar - http://www.microchip.com/stellent/groups/SiteComm_sg/documents/Training_Tutorials/en528035.pdf (http://www.microchip.com/stellent/groups/SiteComm_sg/documents/Training_Tutorials/en528035.pdf)

Typical gate drive waveforms - http://www.richieburnett.co.uk/temp/gdt/gdt2.html####.html (http://www.richieburnett.co.uk/temp/gdt/gdt2.html########.html)

A Current Sensing Tutorial - Part II: Devices - http://www.eetimes.com/document.asp?doc_id=1279415 (http://www.eetimes.com/document.asp?doc_id=1279415)

SMPS AC/DC Reference Design User’s Guide - http://ww1.microchip.com/downloads/en/DeviceDoc/dsPICSMPS%20AC_DC%20Users%20Guide.pdf (http://ww1.microchip.com/downloads/en/DeviceDoc/dsPICSMPS%20AC_DC%20Users%20Guide.pdf)

Amidon Iron Powder Toroidal Cores - http://www.qrz.lt/ly1gp/amidon.html

Iron Powder Toroids - http://www.catzco.com/toroids.htm

TI - Input and Output Capacitor Selection - http://www.ti.com/lit/an/slta055/slta055.pdf (http://www.ti.com/lit/an/slta055/slta055.pdf)

TI - Basic Calculation of a Buck Converter’s Power Stage - http://www.ti.com/lit/an/slva477b/slva477b.pdf (http://www.ti.com/lit/an/slva477b/slva477b.pdf)

TI - Understanding Buck Power Stages in Switchmode Power Supply - http://www.ti.com/lit/an/slva057/slva057.pdf

Linear Devices - Modeling and Loop Compensation Design of Switching Mode Power Supplies - http://cds.linear.com/docs/en/application-note/AN149fa. pdf (http://cds.linear.com/docs/en/application-note/AN149fa.pdf)
40

Modeling of PID controller based SMPS using FPGA - https://www.ijirset.com/upload/december/5-Modeling%20of%20PID%20controller.pdf (https://www.ijirset.com/upload/december/5-Modeling%20of%20PID%20controller.pdf)

Mathworks - Design a PID Controller Using Simulated I/O Data - https://www.mathworks.com/help/slcontrol/examples/design-a-pid-controller-using-simulated-i-o-data. html (https://www.mathworks.com/help/slcontrol/examples/design-a-pid-controller-using-simulated-i-o-data.html)

Mathworks - Plotting System Responses - https://www.mathworks.com/help/control/examples/plotting-system-responses.html (https://www.mathworks.com/help/control/examples/plotting-system-responses.html)

Mathworks - Specify Portion of Model to Linearize - https://www.mathworks.com/help/slcontrol/ug/specify-model-portion-to-linearize.html (https://www.mathworks.com/help/slcontrol/ug/specify-model-portion-to-linearize.html)

Discrete PID for Robotics - http://portal.ku.edu.tr/~cbasdogan/Courses/Robotics/projects/Discrete_PID.pdf (http://portal.ku.edu.tr/~cbasdogan/Courses/Robotics/projects/Discrete_PID.pdf)

EEVBlog - https://www.eevblog.com/forum/projects/pic-silicon-bugs-adc-offset/

Toroids Info - http://toroids.info/

Foro diyAudio - www.diyaudio.com

Foro diySMPS - www.diysmps.com

Sitio Q&A - Electronics StackExchange - http://electronics.stackexchange.com/ (http://electronics.stackexchange.com/)

Para cualquier duda o mayor información pueden escribirnos a torti.max@gmail.com (Torti Andrés) o anchinoleonardo@gmail.com (Anchino Leonardo).

41
