dragondgold/DigitalPowerSupply/Documentacion/buck_nyquist_discrete.png

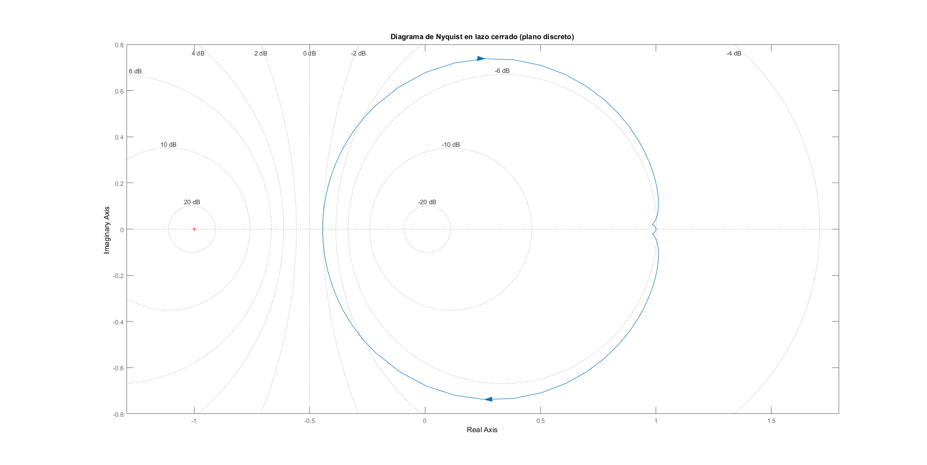
Documentacion/buck_nyquist_discrete.png
