dragondgold/DigitalPowerSupply/Etiquetas Gabinete/High_voltage_warning.svg.png

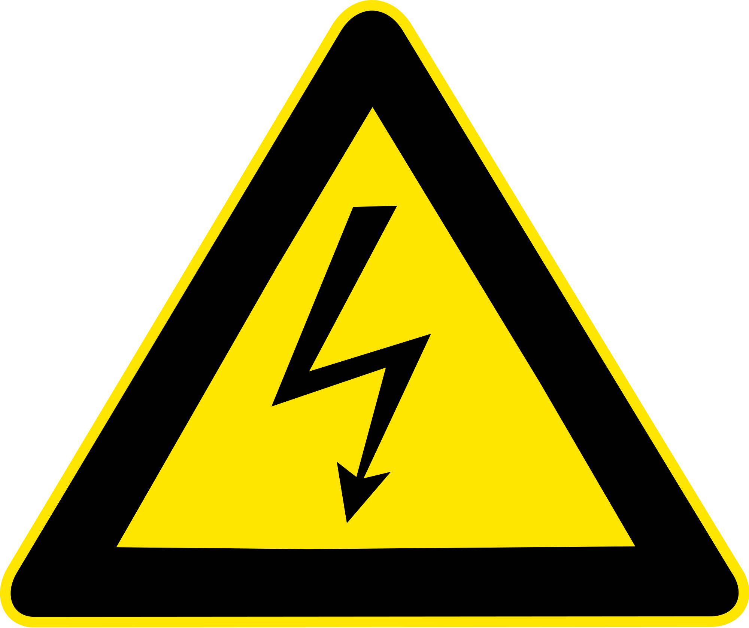
Etiquetas Gabinete/High_voltage_warning.svg.png
