dragondgold/DigitalPowerSupply/Piezas 3D/tecla.gif

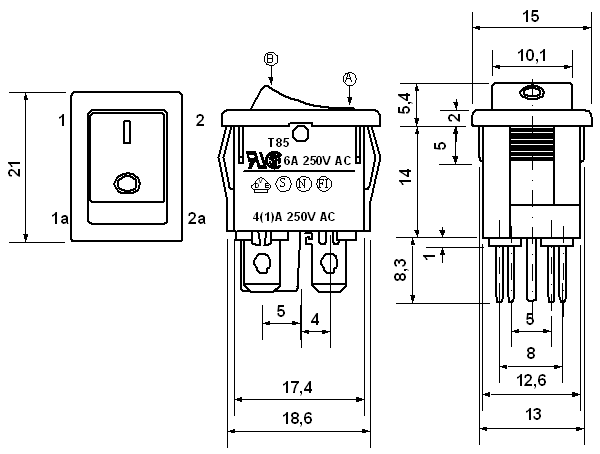
Piezas 3D/tecla.gif
