dragondgold/DigitalPowerSupply/Piezas 3D/tapa trasera.SLDPRT

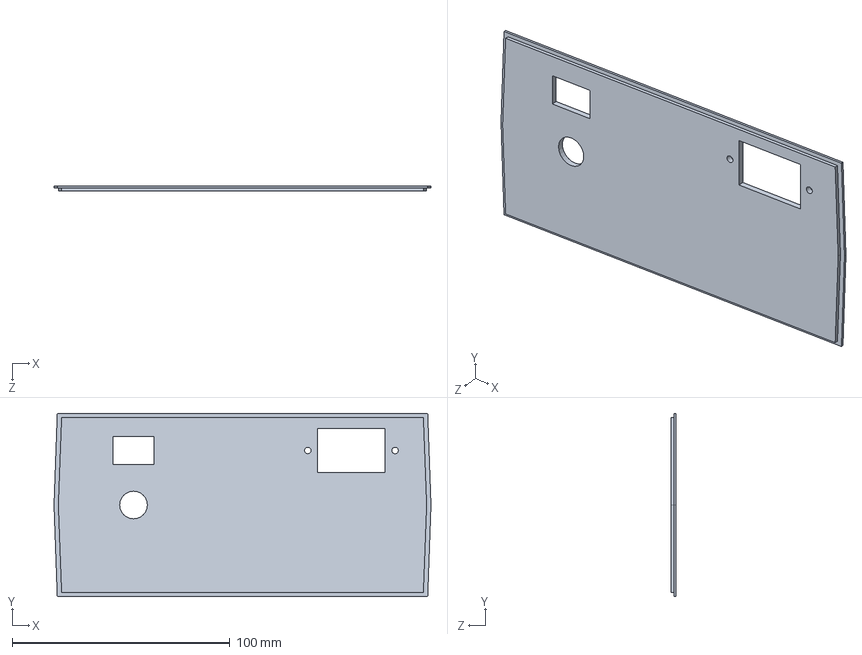
[picture p45: CAD file, 2017-07-31]
Piezas 3D/tapa trasera.SLDPRT
173.0 x 84.0 x 2.50 mm
