dragondgold/DigitalPowerSupply/Piezas 3D/soporte trafo.SLDPRT

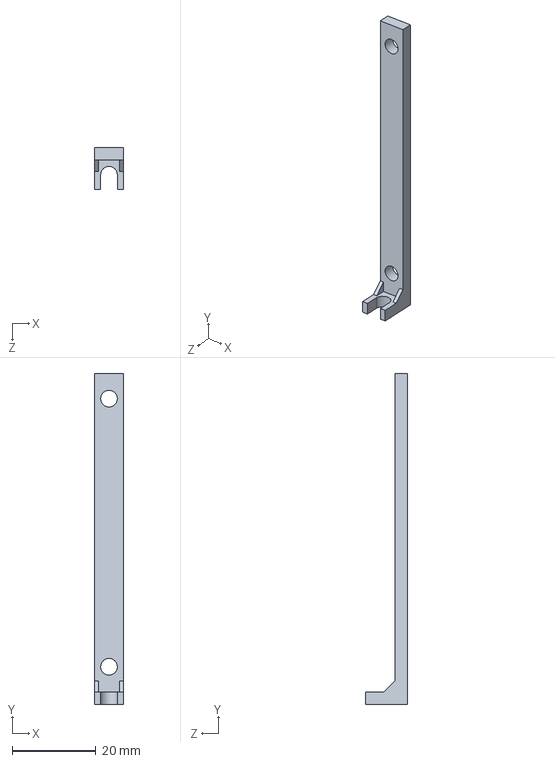
[picture p47: CAD file, 2017-04-20]
Piezas 3D/soporte trafo.SLDPRT
7.00 x 79.0 x 10.0 mm
