dragondgold/DigitalPowerSupply/Piezas 3D/tapa gabinete virgen.SLDPRT

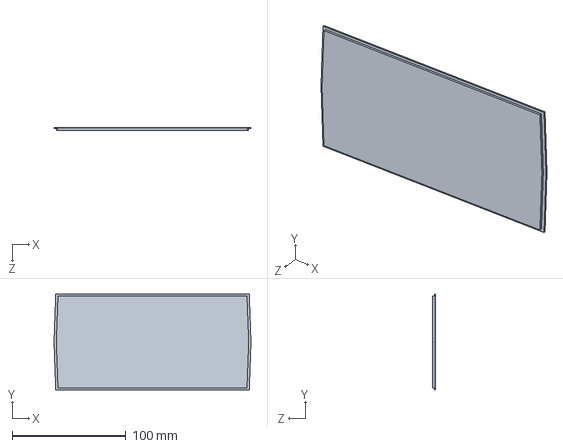
[picture p48: CAD file, 2017-04-20]
Piezas 3D/tapa gabinete virgen.SLDPRT
173.0 x 84.0 x 2.50 mm
