dragondgold/DigitalPowerSupply/Piezas 3D/separador de placas.SLDPRT

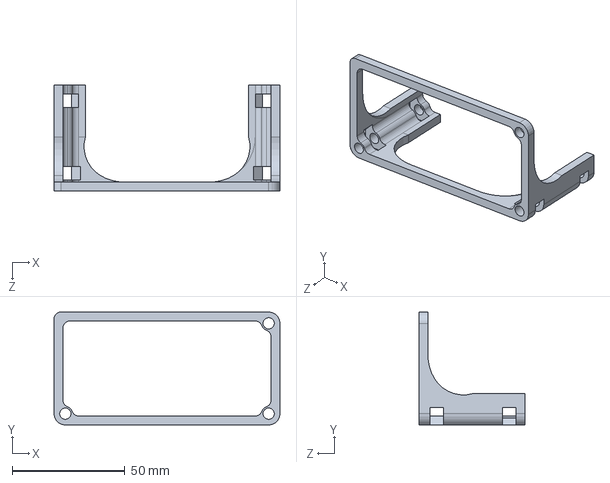
[picture p49: CAD file, 2017-04-20]
Piezas 3D/separador de placas.SLDPRT
100.0 x 50.0 x 47.0 mm
