dragondgold/DigitalPowerSupply/(list of files, cad)

Other CAD files:
Piezas 3D/separador de placas.STL
Piezas 3D/soporte trafo.STL
Piezas 3D/tapa frente.STL
Piezas 3D/tapa trasera.STL
