dragondgold/DigitalPowerSupply/Altium/Control/Control.pdf

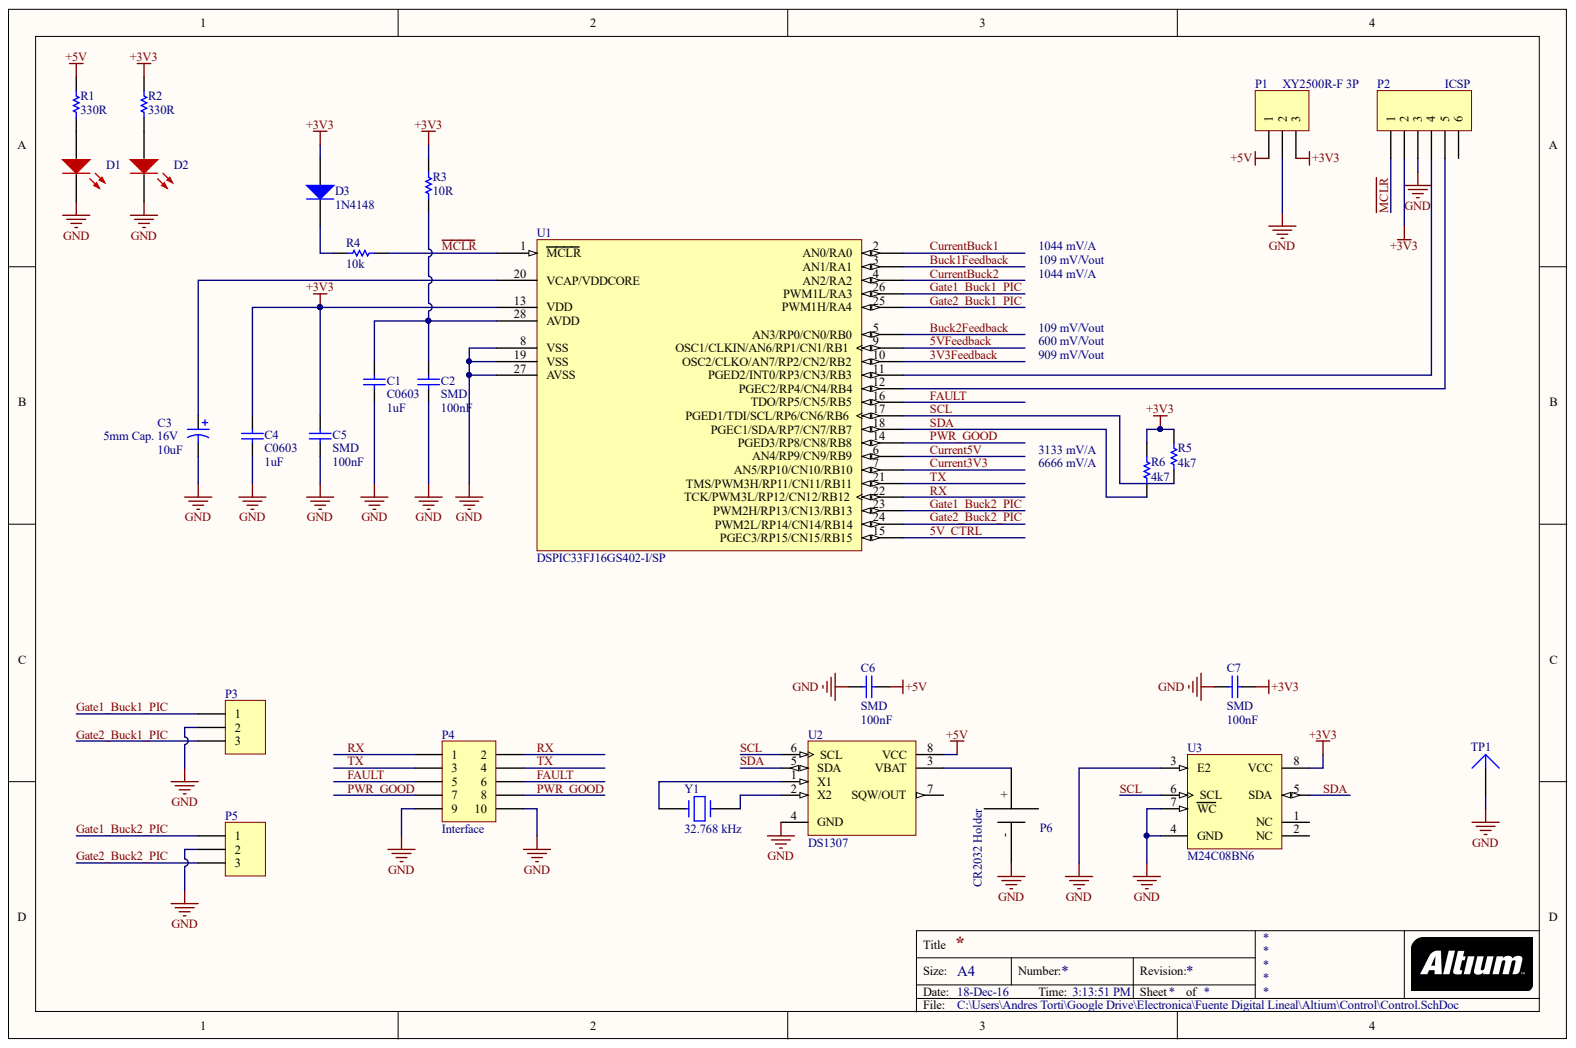
[picture p50: page 1]

A 4 | Numbe r : * | R evision: *

D ate : 18-D e c -16 Time : 3:13:51 P M | | She e t * of *
File : C:\Use rs\Andr es Torti\Google D rive\Ele ctronic a\Fuente Digital Line al\Altium\Control\Control. | S chDoc

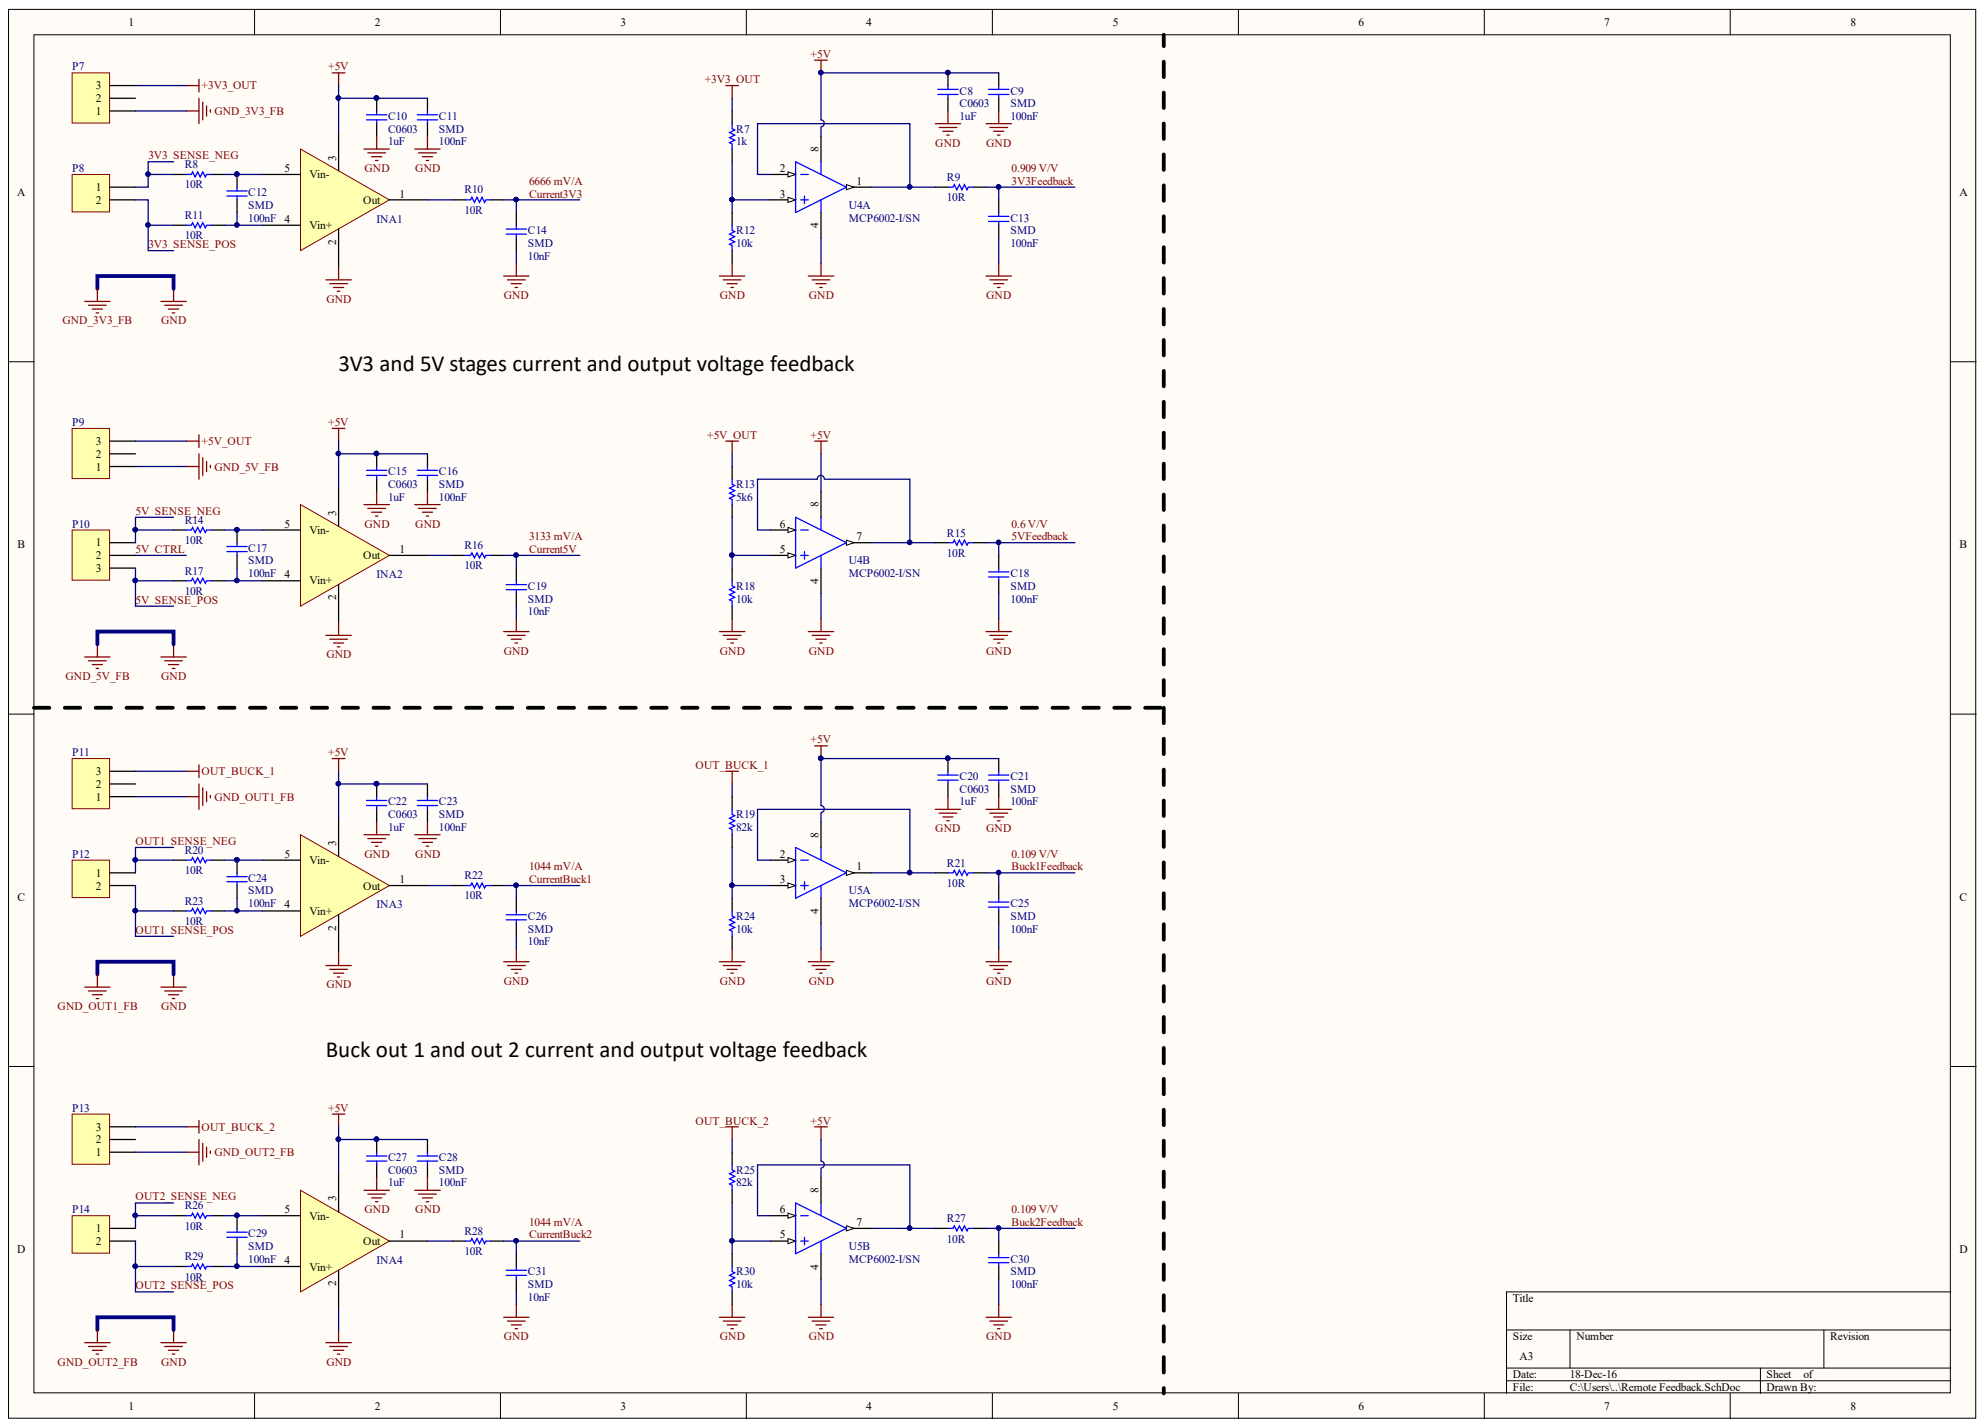
[picture p51: page 2]

3V3 and 5V stages current and output voltage feedback

Buck out 1 and out 2 current and output voltage feedback
