dragondgold/DigitalPowerSupply/(list of files, drawings)

Other design files:
Altium/Control/Control.PcbDoc
Altium/Control/Control.PrjPcb
Altium/Control/Control.SchDoc
Altium/Control/Remote Feedback.SchDoc
Altium/PCB Potencia/5V and 3V3 Outputs.SchDoc
Altium/PCB Potencia/Control.SchDoc
Altium/PCB Potencia/PCB Potencia.PrjPcb
Altium/PCB Potencia/Potencia.PcbDoc
Altium/PCB Potencia/Regulators.SchDoc
Altium/PCB Potencia/Remote Feedback.SchDoc
Altium/PCB Potencia/Variable Output 1.SchDoc
Altium/UI/Botonera/PCB_Project/botonera.PcbDoc
Altium/UI/Botonera/PCB_Project/Botonera.PrjPcb
Altium/UI/Botonera/PCB_Project/botonera.SchDoc
Altium/UI/Schlib1.SchLib
Altium/UI/socket NHD-C12864LZ-FSW-FBW-3V3.PrjPcb
Altium/UI/UI.PcbDoc
Altium/UI/UI.SchDoc
