dragondgold/DigitalPowerSupply/PowerSupplyFirmware.X/definitions.h

/* 
 * File:   definitions.h
 * Author: Andres Torti
 *
 * Created on April 20, 2015, 11:09 AM
 */

#ifndef DEFINITIONS_H
#define	DEFINITIONS_H

#include <xc.h>

#define FCY                         70000000UL
#define SYSTEM_VERSION              "2.0.0"

#define BUCK_CURRENT_ADC_BUFFER     ADCBUF0
#define BUCK_VOLTAGE_ADC_BUFFER     ADCBUF1

#define CURRENT_5V_ADC_BUFFER       ADCBUF2
#define VOLTAGE_5V_ADC_BUFFER       ADCBUF3

#define CURRENT_3V3_ADC_BUFFER      ADCBUF7
#define VOLTAGE_3V3_ADC_BUFFER      ADCBUF18

// Generales
#define ADC_VREF                    3.30

// Parámetros Buck 1
#define BUCK_DEFAULT_PID_ENABLE     1
#define BUCK_PHASE                  3136    // 300kHz
#define BUCK_MAX_DUTY_CYCLE         2823    // 90%
#define BUCK_INITIAL_DUTY_CYCLE     (BUCK_MAX_DUTY_CYCLE/2)
#define BUCK_MIN_DUTY_CYCLE         62      // 2%
#define BUCK_DEAD_TIME              62      // 2%
#define BUCK_MAX_CURRENT            3724    // 3A con 12 bit (del comparador)
#define BUCK_MIN_VOLTAGE            1000    // 1V
#define BUCK_MAX_VOLTAGE            25000   // 25V
#define BUCK_PIC_A_COEFFICIENT      101     // (Kp + Ki*(Ts/2) + Kd/Ts) * 16
#define BUCK_PIC_B_COEFFICIENT      -117    // (-Kp + Ki*(Ts/2) - (2*Kd)/Ts) * 16
#define BUCK_PIC_C_COEFFICIENT      19      // (Kd/Ts) * 16
#define BUCK_PWMH_TRIS              TRISAbits.TRISA4
#define BUCK_PWML_TRIS              TRISAbits.TRISA3
#define BUCK_PWMH_LAT               LATBbits.LATB4
#define BUCK_PWML_LAT               LATBbits.LATB3
#define BUCK_V_FEEDBACK_FACTOR      0.10665
#define BUCK_I_FEEDBACK_FACTOR      1.000   // mV/mA
#define BUCK_CURRENT_ADC_COUNTS     4096    // 12 bits
#define BUCK_VOLTAGE_ADC_COUNTS     4096    // 12 bits
// Este factor permite convertir la multiplicación de tensión*corriente en valores de ADC al valor
//  correspondiente en Watts. La ventaja de esto es que en la interrupción podemos multiplicar los
//  valores enteros del ADC rápidamente y para obtener el valor de potencia en Watts multiplicar por
//  este factor posteriormente:
//
// W = (ADC_V * ADC_I) * ((Vref^2)/(ADC_COUNT_I * ADC_COUNT_V) / (FACTOR_V * FACTOR_I))
#define BUCK_W_FACTOR               (((ADC_VREF*ADC_VREF)/((double)BUCK_VOLTAGE_ADC_COUNTS*(double)BUCK_CURRENT_ADC_COUNTS)) / (BUCK_V_FEEDBACK_FACTOR * BUCK_I_FEEDBACK_FACTOR))
#define BUCK_ADC_VOLTAGE_GAIN       0.9636
#define BUCK_ADC_VOLTAGE_OFFSET     44.275
#define BUCK_ADC_CURRENT_GAIN       0.9956
#define BUCK_ADC_CURRENT_OFFSET     62.000

// Parámetros lineas auxiliares
#define AUX_ADC_COUNTS              4096

#define MAX_CURRENT_5V              2482    // 1A
#define ON_OFF_5V_TRIS              TRISBbits.TRISB1  
#define ON_OFF_5V_LAT               LATBbits.LATB1
#define AUX_5V_V_FEEDBACK_FACTOR    0.6375
#define AUX_5V_I_FEEDBACK_FACTOR    2.000   // mV/mA
#define AUX_5V_W_FACTOR             (((ADC_VREF*ADC_VREF)/((double)AUX_ADC_COUNTS*(double)AUX_ADC_COUNTS)) / (AUX_5V_V_FEEDBACK_FACTOR * AUX_5V_I_FEEDBACK_FACTOR))
#define AUX_5V_VOLTAGE_GAIN         0.9763
#define AUX_5V_VOLTAGE_OFFSET       6.7614

#define MAX_CURRENT_3V3             1117    // 0.3A
#define AUX_3V3_V_FEEDBACK_FACTOR   0.955
#define AUX_3V3_I_FEEDBACK_FACTOR   3.000   // mV/mA
#define AUX_3V3_W_FACTOR            (((ADC_VREF*ADC_VREF)/((double)AUX_ADC_COUNTS*(double)AUX_ADC_COUNTS)) / (AUX_3V3_V_FEEDBACK_FACTOR * AUX_3V3_I_FEEDBACK_FACTOR))
#define AUX_3V3_VOLTAGE_GAIN        1.108
#define AUX_3V3_VOLTAGE_OFFSET      326.03

// Modulo UART
#define RX_TRIS                 TRISBbits.TRISB12
#define TX_TRIS                 TRISBbits.TRISB11
#define RX_DEBUG_TRIS           TRISBbits.TRISB14
#define TX_DEBUG_TRIS           TRISBbits.TRISB13

// Salidas de estado
#define FAULT_TRIS              TRISBbits.TRISB5
#define FAULT_LAT               LATBbits.LATB5
#define PWR_GOOD_TRIS           TRISBbits.TRISB15
#define PWR_GOOD_LAT            LATBbits.LATB15

// Entradas analógicas
#define BUCK_CURRENT_TRIS       TRISAbits.TRISA0
#define BUCK_VOLTAGE_TRIS       TRISAbits.TRISA1
#define AUX_5V_CURRENT_TRIS     TRISAbits.TRISA2
#define AUX_5V_VOLTAGE_TRIS     TRISBbits.TRISB0
#define AUX_3V_CURRENT_TRIS     TRISBbits.TRISB2
#define AUX_3V_VOLTAGE_TRIS     TRISBbits.TRISB3

#endif	/* DEFINITIONS_H */
