dragondgold/DigitalPowerSupply/(commit log)

2017-04-20 Altium Commit
    [5V and 3V3 Outputs.SchDoc, PCB Potencia.PrjPcb, Potencia.PcbDoc, Regulators.SchDoc, Variable Output 1.SchDoc, Variable Output 2.SchDoc]
2017-04-24 First commit for version 2.0
    [5V and 3V3 Outputs.SchDoc, PCB Potencia.PrjPcb, Potencia.PcbDoc, Regulators.SchDoc, Variable Output 1.SchDoc, Variable Output 2.SchDoc]
2017-04-24 Removed duplicated files
    [5V and 3V3 Outputs.SchDoc, PCB Potencia.PrjPcb, Potencia.PcbDoc, Regulators.SchDoc, Variable Output 1.SchDoc, Variable Output 2.SchDoc]
2017-04-24 Added missing PCB file
    [Test.PcbDoc]
2017-04-24 Buck1 + buck2 on test.pcbdoc
    [PCB Potencia.PrjPcb, Test.PcbDoc, Variable Output 2.SchDoc]
2017-04-24 New power stage for the power supply. One buck was removed to make the components fit in 100x50mm.
    [5V and 3V3 Outputs.SchDoc, Control.SchDoc, PCB Potencia.PrjPcb, Potencia.PcbDoc, Regulators.SchDoc, Variable Output 1.SchDoc, Variable Output 2.SchDoc]
2017-04-24 First changes to control circuit for v2.0
    [Control.SchDoc, Potencia.PcbDoc]
2017-04-25 New v2.0 control board
    [5V and 3V3 Outputs.SchDoc, Control.SchDoc, PCB Potencia.PrjPcb, Potencia.PcbDoc, Remote Feedback.SchDoc, Test.PcbDoc]
2017-04-26 Added testpoints to the control PCB
    [Potencia.PcbDoc]
2017-04-26 Minor fixes and added fabrication output job
    [5V and 3V3 Outputs.SchDoc, PCB Potencia.PrjPcb, Potencia.PcbDoc, Variable Output 1.SchDoc]
2017-07-28 Ported firmware to dsPIC33EP64GS502 to work with the new board
    [Control.SchDoc, PCB Potencia.PrjPcb, Potencia.PcbDoc, Remote Feedback.SchDoc]
2017-07-29 smps: Added average power calculations command parser: Added "GET_ALL_STRING" command project: changed file encoding to UTF-8 so accents play nice with git
2017-07-31 PCB Botonera +nuevo UI firmware
    [Botonera.PrjPcb, botonera.PcbDoc, botonera.SchDoc]
2017-07-31 New front and back sides for the enclosure
    [tapa frente.SLDPRT, tapa frente.STL, tapa trasera.SLDPRT, tapa trasera.STL]
2017-07-31 Fixed current and voltage factors
    [definitions.h]
2017-08-01 Programa Ui nuevo con u8g2lib falta arreglar contraste
    [test.ino]
2017-08-02 Use analog comparators to detect overcurrent conditions instead of ADC
2017-08-02 Fixed too low duty cycle not letting PWML to switch and preventing bootstrap capacitor from charging
    [definitions.h]
2017-08-02 Fixed bugs and improved command parser
    [command-parser.c, command-parser.h, debug-uart.c, traps.c]
2017-08-04 Added profiles functionality
    [UI.PcbDoc]
2017-08-07 Updated documentation
    [PCB Potencia.PrjPcb, Remote Feedback.SchDoc, Variable Output 1.SchDoc]
2017-08-07 Various fixes and improvements
    [command-parser.c, command-parser.h, definitions.h, smps.c, smps.h, traps.c]
2017-08-09 UI - Bug: Problem when load an existing profile
    [test.ino]
2017-08-09 UI - Fixed bug when load an existing profile
    [test.ino]
2017-08-10 Limit buck max and min voltage on dsPIC
2017-08-22 New Simulink simulations. New PID algorithm. General bug fixes.
    [ADC Coefficients.xlsx, PCB Potencia.PrjPcb]
2017-08-23 Send average current/voltage and power values to the LCD
2017-08-24 New PID constants and calibrated 5V and 3.3V outputs
2017-08-24 Added new profile and fix screen bleach
    [test.ino]
2017-08-24 Calibrated voltage outputs. Updated documentation.
    [ADC Coefficients.xlsx]
2017-08-24 Added simulink test simulation for the buck converter
